ODZ-UJF-AV-CR/balon/SW/spi/README.md

PCRD detector scripts

Add following lines to /etc/modules in order to preload modules requiered for communication with the detector:

    spi-s3c64xx
    spidev
