ODZ-UJF-AV-CR/balon/doc/FIK_flights.odt

Flight | FIK-1 | FIK-2 | SP9UOB | FIK-3 | FIK-4 | FIK-5 | FIK-6 | FIK-7
Location | CZ (2015) | CZ (2017) | PL | CZ (2018) | SE (2019) | CZ (2019) | CZ (2020) | CZ (2021)
Payload | Candy detector Web camera | Candy detector, 360 deg camera | AIRDOS | AIRDOS | AIRDOS, SPACEDOS, GM, Socrat-R | AIRDOSC, SPACEDOS, GM, 360 deg camera | AIRDOSC, SPACEDOS, GM, Ionmeter, 360 deg camera | SPACEDOS, PiTED, 360 deg camera
Landing site | vineyard Austria | rapeseed field | | Poland | swamp | forest | railway corridor | Poland
Power source | Li-ion 18650 accu | Li-ion 18650 and li-pol accu | | Lithium primary cells and li-pol accu | Lithium primary cells | Lithium primary cells and LiIon Power Bank | Li-ion 18650 accu and LiIon Power Bank | Lithium primary cell and LiIon Power Bank
Telemetry system | GSM | GSM 868 MHz Proprietary Modem | Outsourced | SigFox (Poland) Proprietary Modem | Outsourced | 1x LoRa 1x SigFox 1x SiK 433 MHz | 2x LoRa 1x SiK 433 MHz | 1x LoRa
Rescue beacon | 433 MHz CW | 433 MHz CW | | 433 MHz CW | Outsourced | 433 MHz CW | 433 MHz CW | 433 MHz CW
Flight control computer | Odroid-U2 | Odroid-U2 | | Not used | Not used/outsourced | PX4, FMU v5 | PX4, FMU v5 | DATALOGGER01A
