ODZ-UJF-AV-CR/balon/data/151219_flight/3-spectrum/README.md

# Ballon data analyse

## Separation of noise

We can see a noise at low channels of the PCRD.

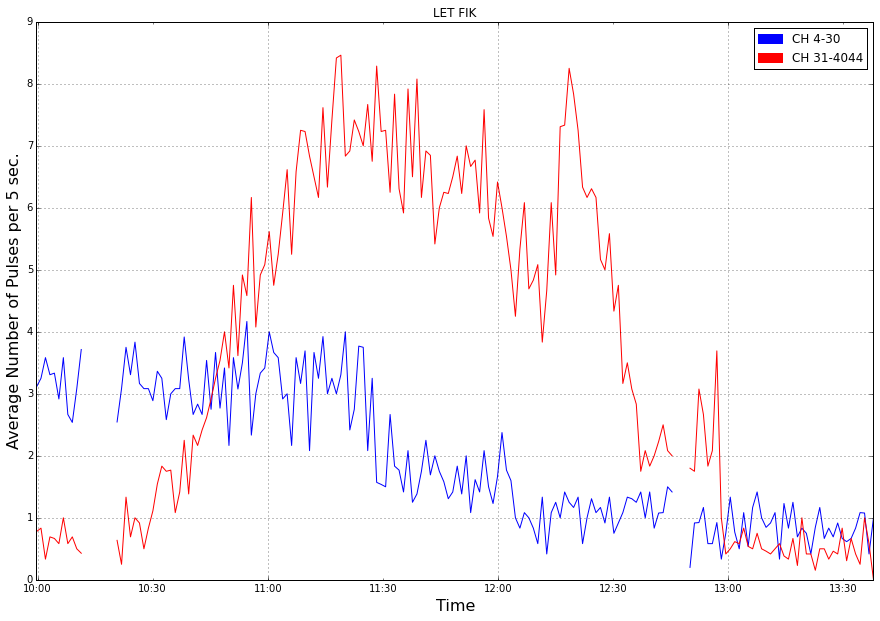
[picture p5: data/151219_flight/3-spectrum/noise.png]
Noise visualisation


## Energy spectrum

There is an energy spectrum aggregated from each 2 km altitude.

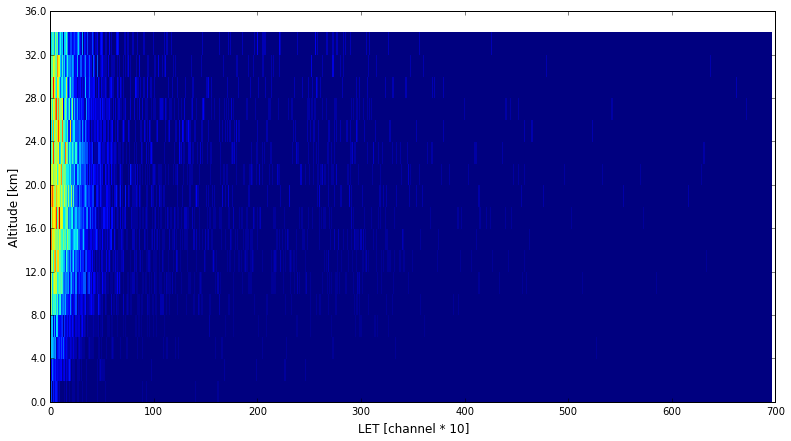
[picture p6: data/151219_flight/3-spectrum/spectrum.png]
Energy spectrum
