ODZ-UJF-AV-CR/balon/SW/Telemetry_receiver/sigfox/README.md

# CLI based Balloon telemetry decoder 

### Compilation

    gcc BalloonPos.cpp -o BalloonPos

### Usage 

    ./BalloonPos

Then enter the sigfox message. For example: 23a0fc0a3c1300f606c20993
You should get following as output: 

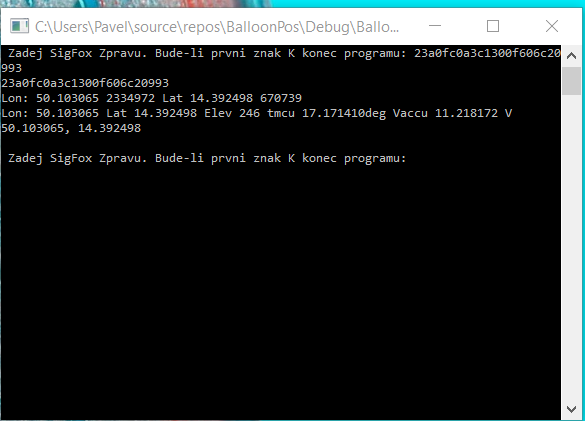
[picture p7: SW/Telemetry_receiver/sigfox/example_screenshot.png]
Decoded Balloon position from sigfox message Sigfox decoder output


# Web based Balloon telemetry decoder 

### Usage 

    python habitat_sigfox_uploader.py LetFik3

### Testing
 
    curl -G --data "data=23a0fc0a3c1300f606c20993" localhost:8080

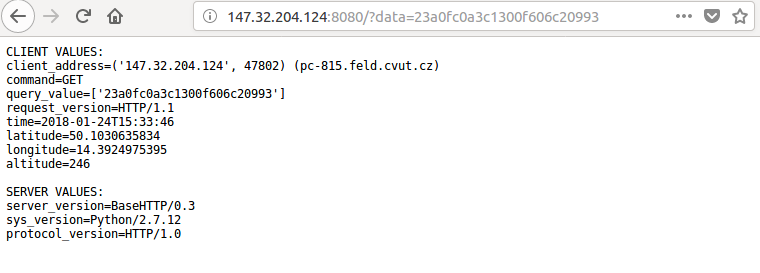
[picture p8: SW/Telemetry_receiver/sigfox/sigfox_web_interface.png]
Decoded Balloon position from sigfox API Sigfox Web interface decoder
