ODZ-UJF-AV-CR/balon/CAD/src/Receiver_box/Receiver_box_Small.png

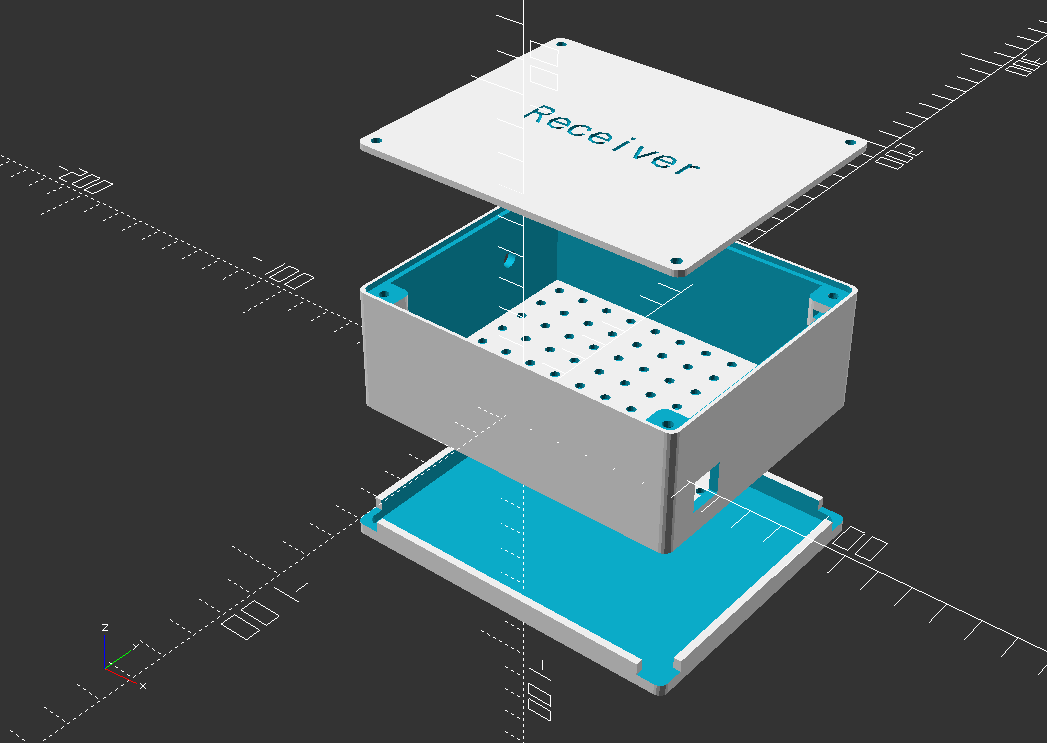
CAD/src/Receiver_box/Receiver_box_Small.png
