ODZ-UJF-AV-CR/balon/data/170318_flight/notes/altitude-and-position/fik2.png

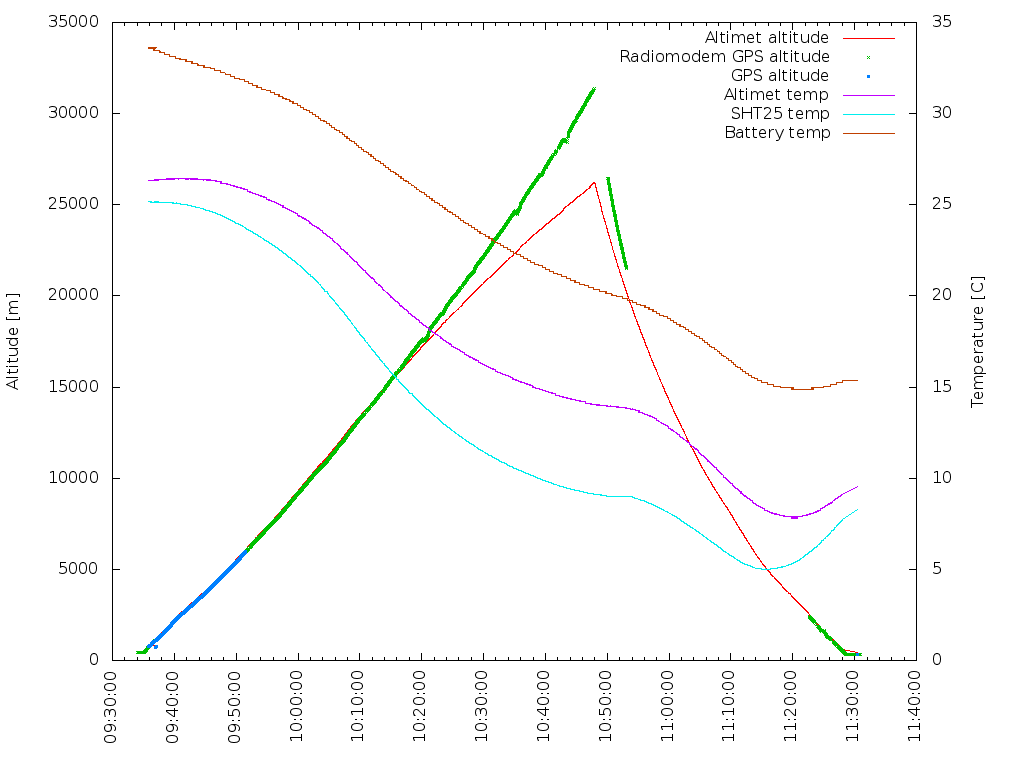
data/170318_flight/notes/altitude-and-position/fik2.png
