ODZ-UJF-AV-CR/balon/doc/433MHz_car_antenna/img/433MHz_antenna1.jpg

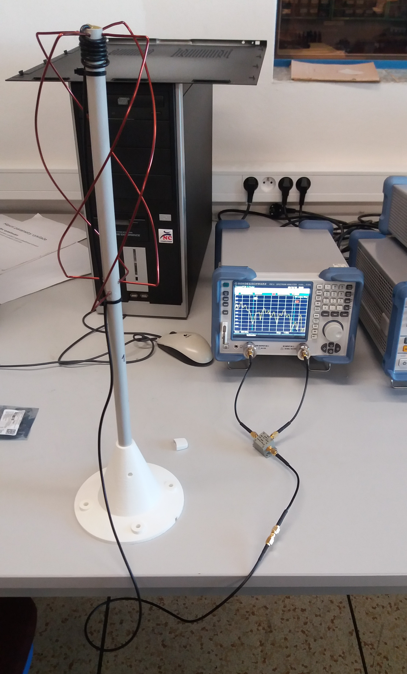
doc/433MHz_car_antenna/img/433MHz_antenna1.jpg
