ODZ-UJF-AV-CR/balon/doc/433MHz_car_antenna/img/433MHz_antenna1_S11.png

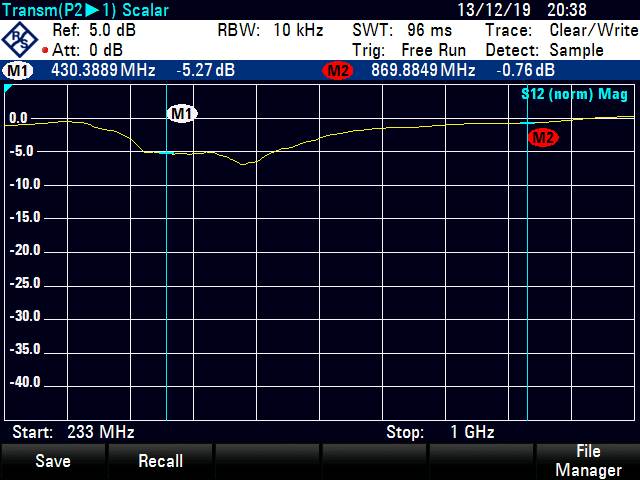
doc/433MHz_car_antenna/img/433MHz_antenna1_S11.png
