ODZ-UJF-AV-CR/balon/doc/433MHz_car_antenna/img/slicing.png

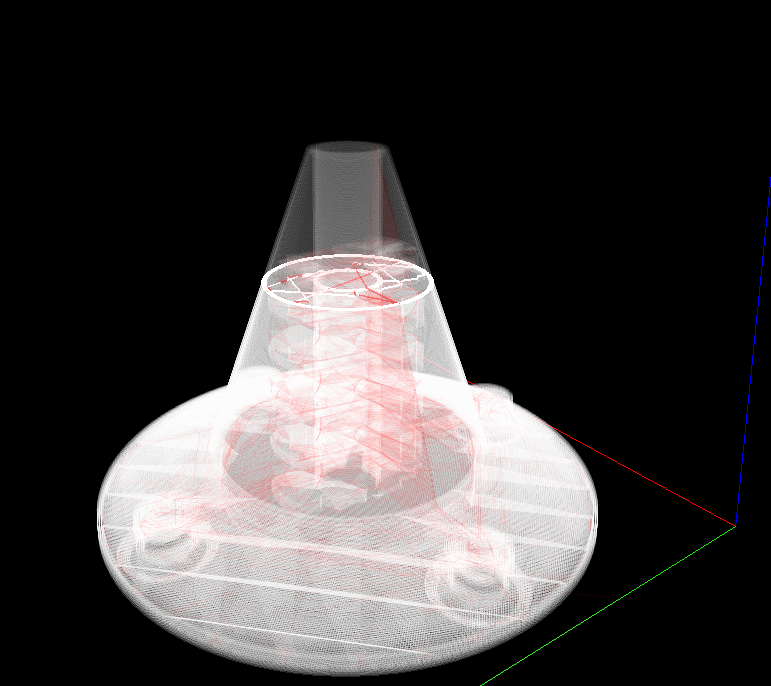
doc/433MHz_car_antenna/img/slicing.png
