ODZ-UJF-AV-CR/balon/doc/GPSdataloger/datalogger_blocks.png

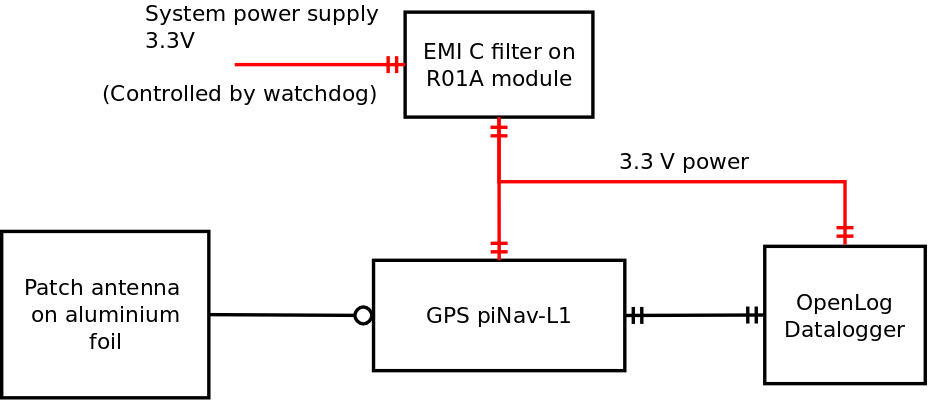
doc/GPSdataloger/datalogger_blocks.png
