ODZ-UJF-AV-CR/balon/doc/Transceiver/img/20170310_132159.jpg

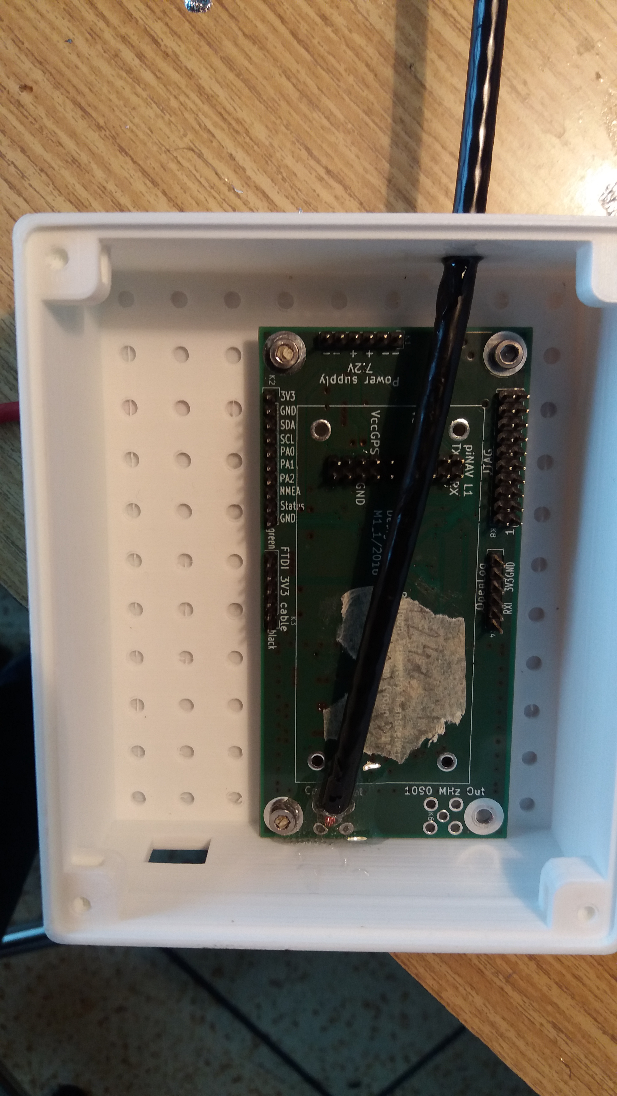
doc/Transceiver/img/20170310_132159.jpg
