ODZ-UJF-AV-CR/balon/doc/Transceiver/img/20170310_132207.jpg

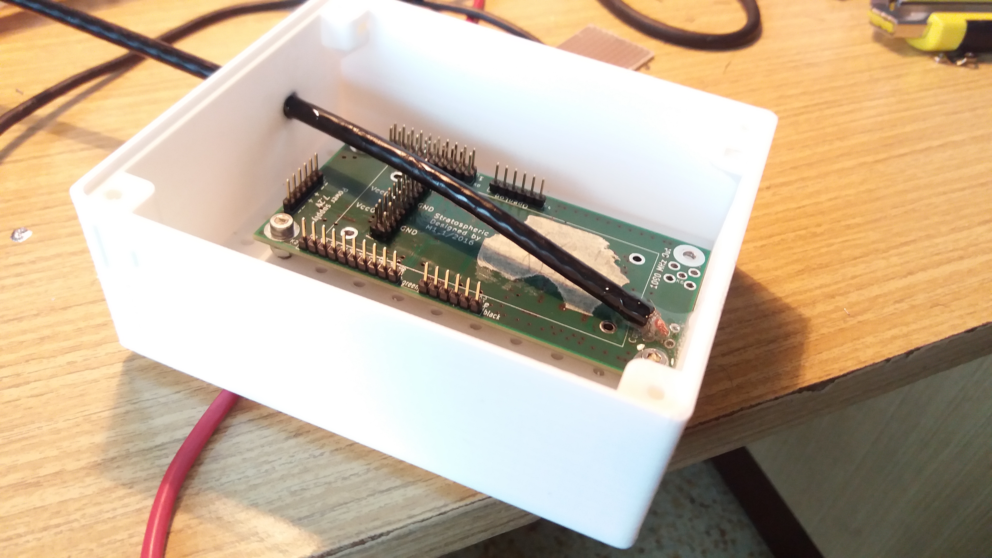
doc/Transceiver/img/20170310_132207.jpg
