ODZ-UJF-AV-CR/balon/fik5/telemetry/20190923_163317.jpg

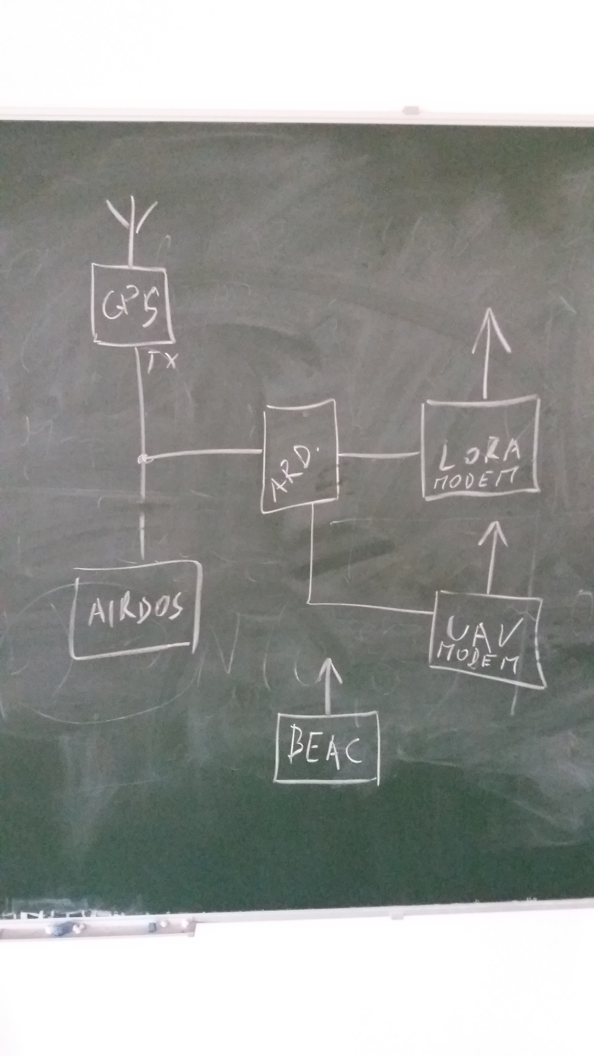
fik5/telemetry/20190923_163317.jpg
