ODZ-UJF-AV-CR/balon/HW/transceiver_M1_1_2016/modballoon.png

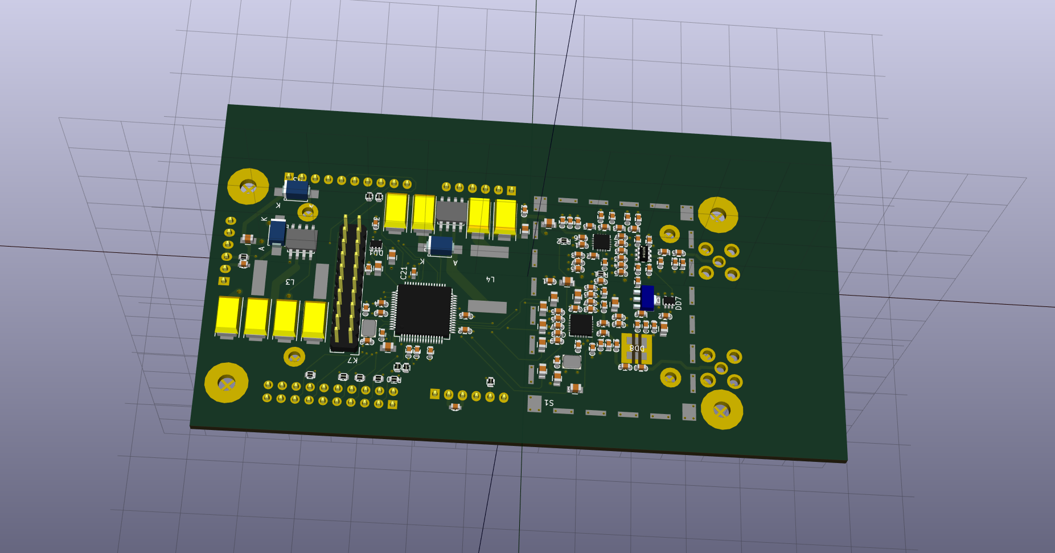
HW/transceiver_M1_1_2016/modballoon.png
