ODZ-UJF-AV-CR/balon/presentation/bloky/schema.png

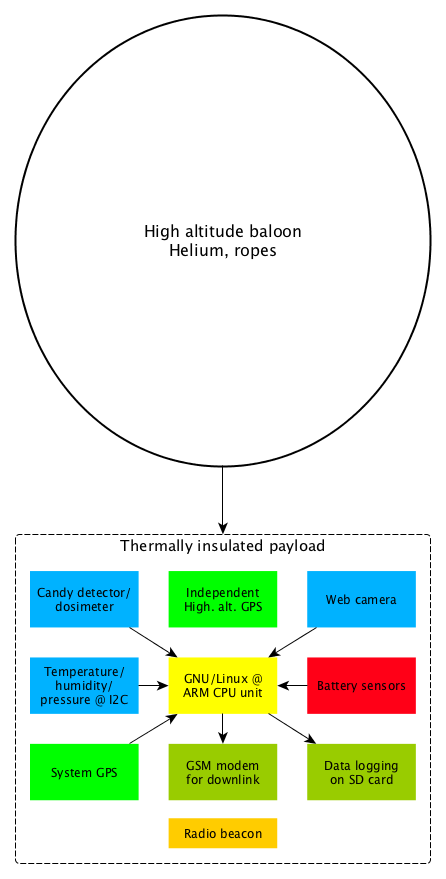
presentation/bloky/schema.png
