ODZ-UJF-AV-CR/balon/SW/beacon/DOC/beacon_schematics.png

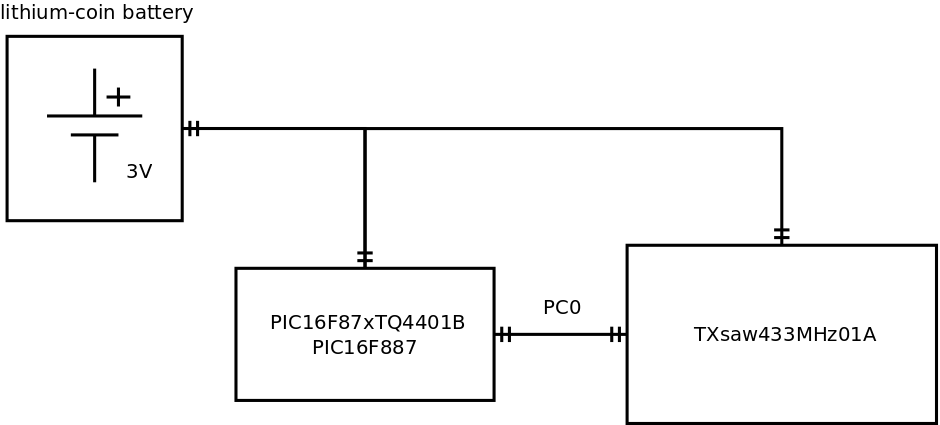
SW/beacon/DOC/beacon_schematics.png
