ODZ-UJF-AV-CR/balon/CAD/src/Receiver_box/AMF/assembly.stl

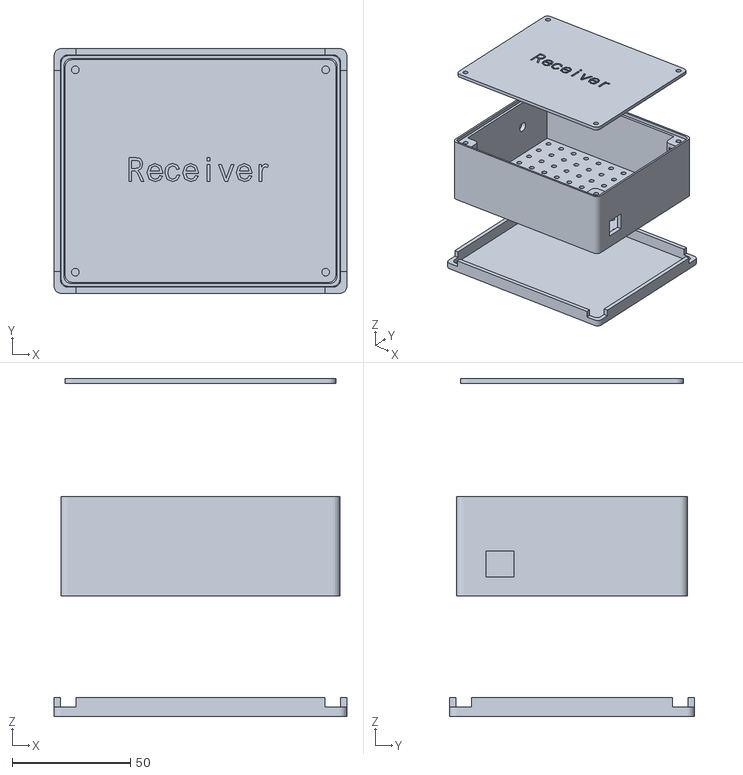
[picture p26: CAD file, 2017-03-09]
CAD/src/Receiver_box/AMF/assembly.stl
124.0 x 103.7 x 143.1
