ODZ-UJF-AV-CR/balon/CAD/src/Receiver_box/AMF/BASEBOX02A_kryt.stl

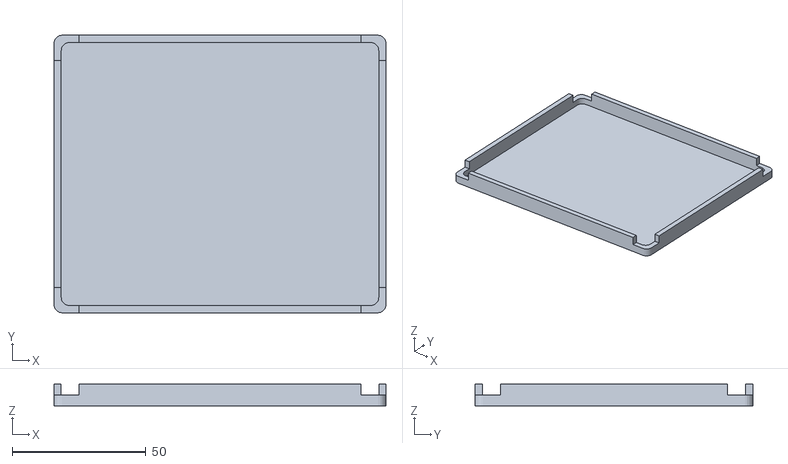
[picture p27: CAD file, 2017-03-15]
CAD/src/Receiver_box/AMF/BASEBOX02A_kryt.stl
124.0 x 103.7 x 8.10
