ODZ-UJF-AV-CR/balon/CAD/STL/camera_holder.stl

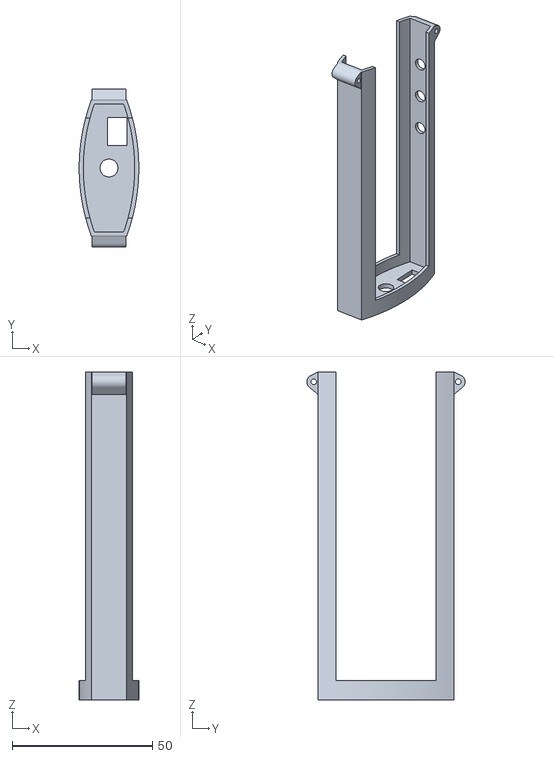
[picture p28: CAD file, 2019-11-26]
CAD/STL/camera_holder.stl
21.3 x 56.5 x 117.0
