ODZ-UJF-AV-CR/balon/CAD/src/Receiver_box/AMF/BASEBOX02A.stl

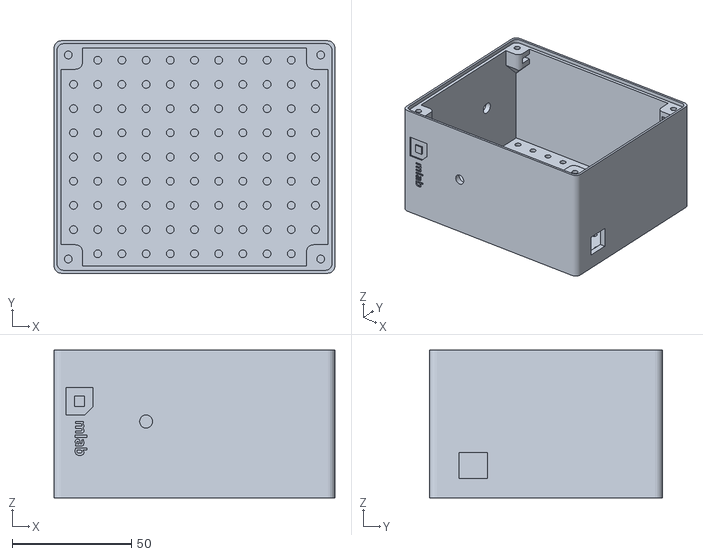
[picture p29: CAD file, 2017-03-13]
CAD/src/Receiver_box/AMF/BASEBOX02A.stl
118.0 x 97.7 x 62.1
