ODZ-UJF-AV-CR/balon/CAD/STL/antenna_holder.stl

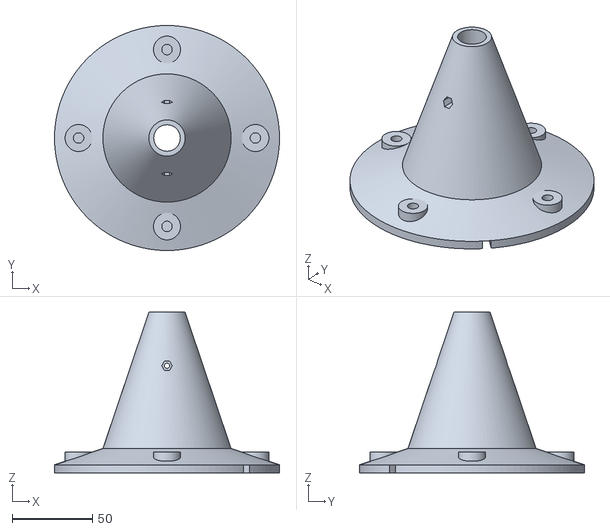
[picture p30: CAD file, 2019-11-21]
CAD/STL/antenna_holder.stl
140.0 x 140.0 x 100.0
