ODZ-UJF-AV-CR/balon/CAD/src/Receiver_box/AMF/BASEBOX02A_PLBASE_top.stl

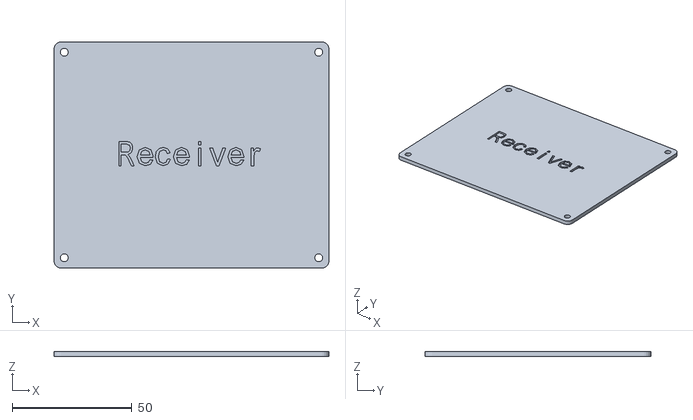
[picture p31: CAD file, 2017-03-09]
CAD/src/Receiver_box/AMF/BASEBOX02A_PLBASE_top.stl
114.6 x 94.3 x 2.10
