ODZ-UJF-AV-CR/balon/CAD/STL/VzorkovnikSloupkuNaSroubM3.stl

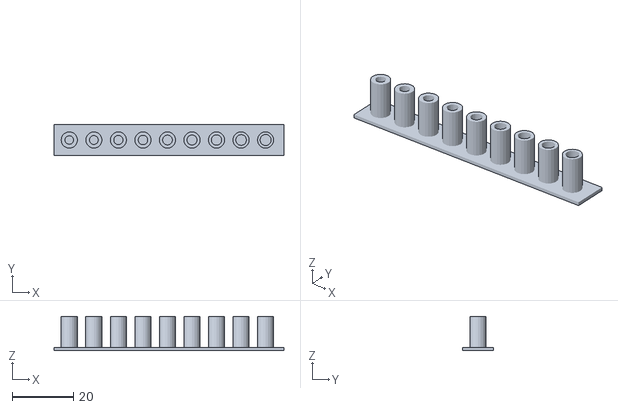
[picture p32: CAD file, 2018-01-23]
CAD/STL/VzorkovnikSloupkuNaSroubM3.stl
75.0 x 10.0 x 11.2
