ODZ-UJF-AV-CR/balon/CAD/STL/BoxBase-Fik3.stl

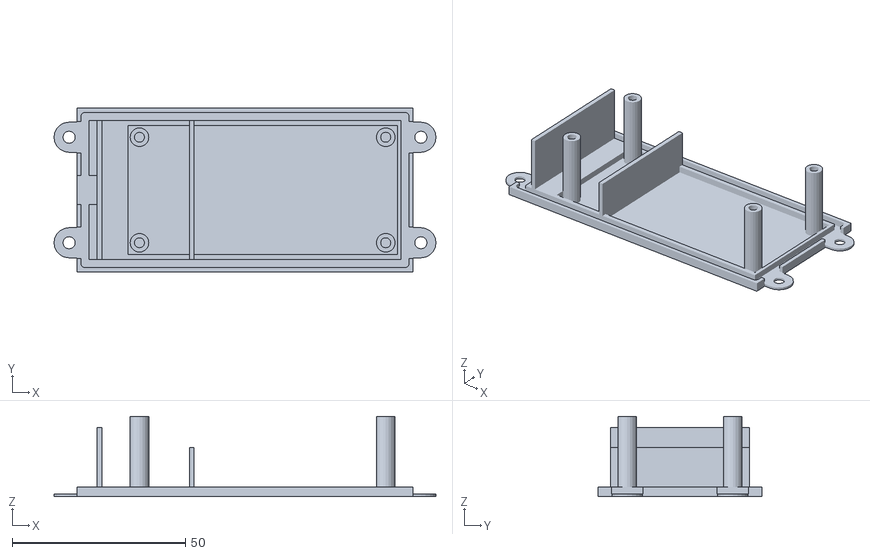
[picture p33: CAD file, 2018-01-22]
CAD/STL/BoxBase-Fik3.stl
110.3 x 47.2 x 23.2
