ODZ-UJF-AV-CR/balon/CAD/STL/Box-Fik3.stl

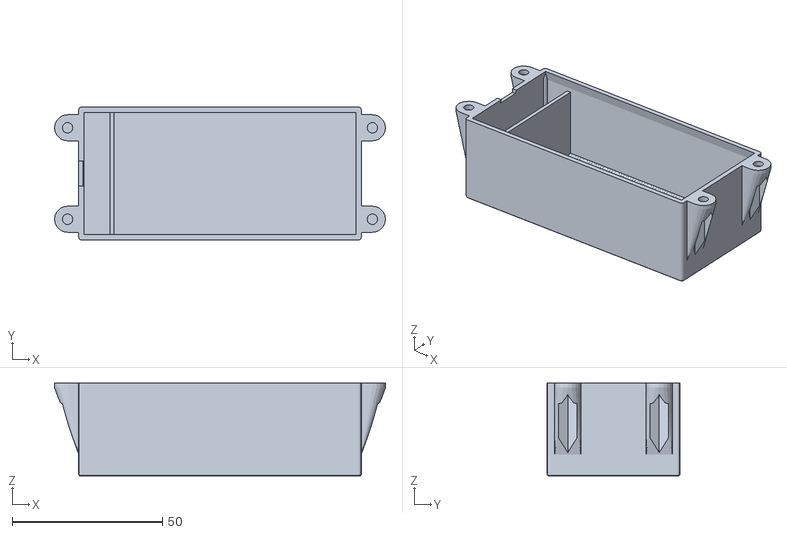
[picture p34: CAD file, 2018-01-21]
CAD/STL/Box-Fik3.stl
110.3 x 44.2 x 30.9
