ODZ-UJF-AV-CR/balon/CAD/STL/Base-Fik3.stl

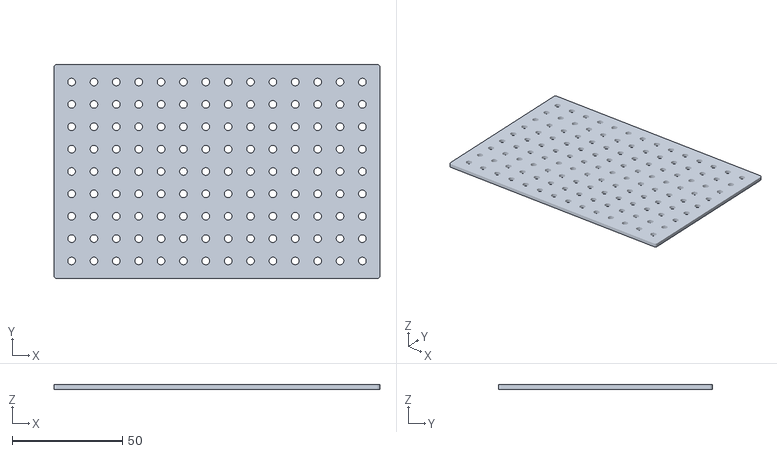
[picture p35: CAD file, 2018-01-19]
CAD/STL/Base-Fik3.stl
148.1 x 97.3 x 2.10
