ODZ-UJF-AV-CR/balon/CAD/STL/Grid_Holder_longer.stl

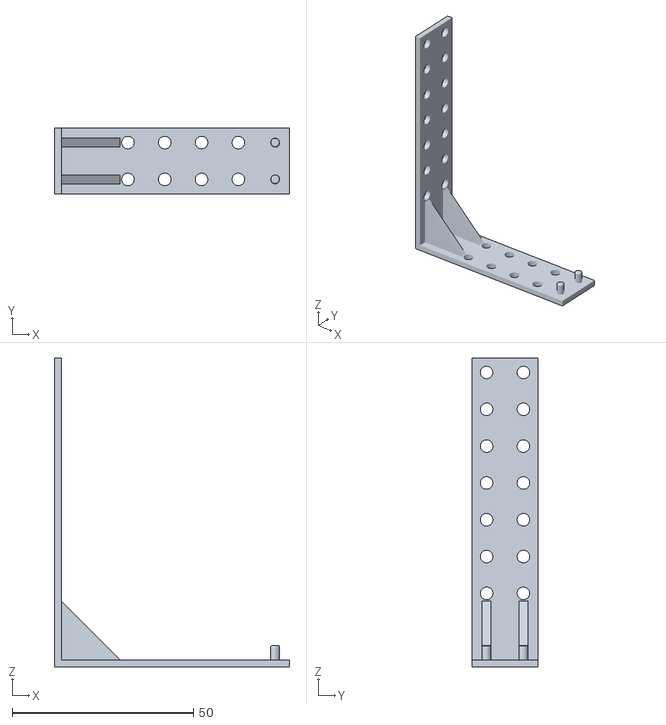
[picture p36: CAD file, 2017-03-16]
CAD/STL/Grid_Holder_longer.stl
65.0 x 18.2 x 85.3
