ODZ-UJF-AV-CR/balon/CAD/STL/Grid_holder.stl

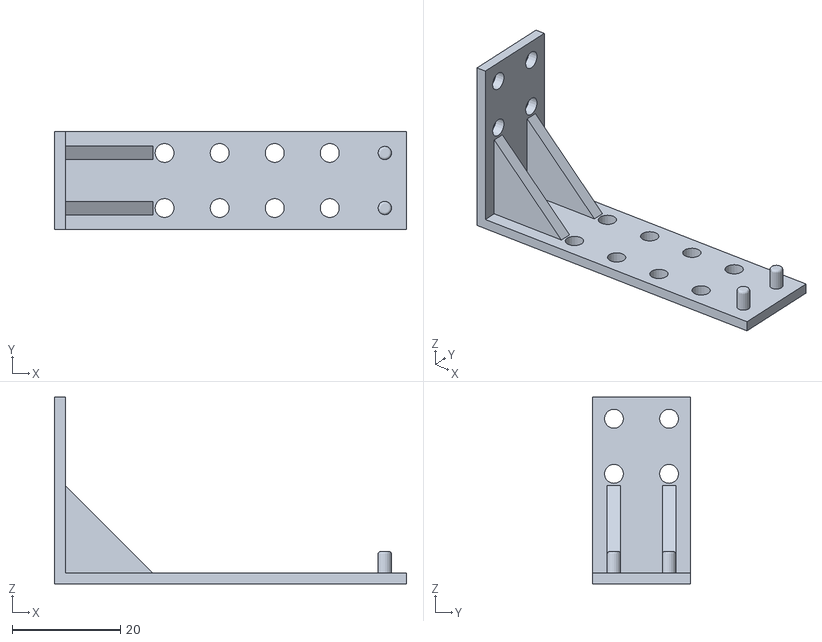
[picture p37: CAD file, 2017-03-15]
CAD/STL/Grid_holder.stl
65.0 x 18.2 x 34.5
