ODZ-UJF-AV-CR/balon/CAD/STL/Deska+C1_14.stl

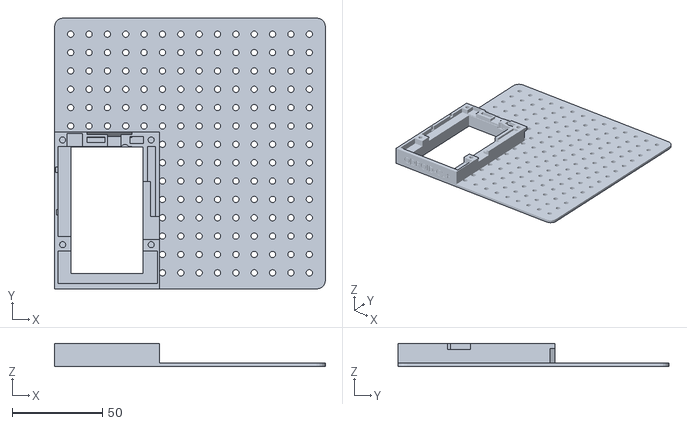
[picture p38: CAD file, 2017-03-09]
CAD/STL/Deska+C1_14.stl
150.0 x 150.0 x 13.0
