ODZ-UJF-AV-CR/balon/CAD/STL/PLBASE1515.stl

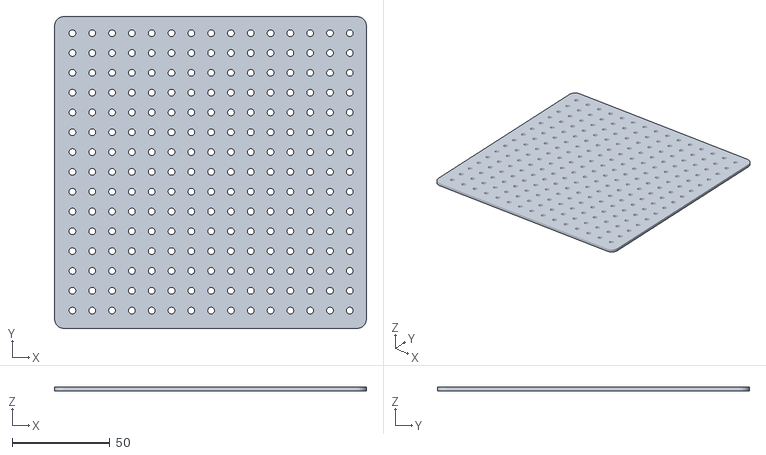
[picture p39: CAD file, 2015-12-07]
CAD/STL/PLBASE1515.stl
160.0 x 160.0 x 2.10
