ODZ-UJF-AV-CR/balon/(list of files, cad)

Other CAD files:
CAD/src/Receiver_box/src/text/Letters.dxf
CAD/src/PCRD_BOX/box_base.scad
CAD/src/PCRD_BOX/box_grid.scad
CAD/src/PCRD_BOX/box_top.scad
CAD/src/PCRD_BOX/Grid_Holder.scad
CAD/src/PCRD_BOX/Pokus6.scad
CAD/src/PCRD_BOX/Pokus7.scad
CAD/src/PLBASE1515.scad
CAD/src/Receiver_box/assembly.scad
CAD/src/Receiver_box/print_data/BASEBOX02A.scad
CAD/src/Receiver_box/print_data/BASEBOX02A_PLBASE_top.scad
CAD/src/Receiver_box/print_data/BASEBOX02A_kryt.scad
CAD/src/Receiver_box/src/MLAB_logo.scad
CAD/src/Receiver_box/src/manufactury_conf.scad
CAD/src/Receiver_box/src/otvory_conf.scad
CAD/src/Receiver_box/src/plbase.scad
CAD/src/Receiver_box/src/produkt_logo.scad
CAD/src/Receiver_box/src/sloupek.scad
CAD/src/Receiver_box/src/spodni_kryt.scad
CAD/src/Receiver_box/src/text/Write.scad
