ODZ-UJF-AV-CR/balon/(threads)

Thread 7 (2015-12-04):

Test hardware failure of sensor by sensor

vaclavstepan, 2015-12-04:

Closed 2019-09-16.

Thread 8 (2015-12-04):

Modem reset handling via i2c

vaclavstepan, 2015-12-04:

vaclavstepan, 2015-12-08:
On modem board there's reset and pwr_on pin. We might need to handle both?

vaclavstepan, 2015-12-16:
Vyžaduje druhý i2c hub, teď prostě nebude.

Closed 2015-12-16.

Thread 15 (2015-12-16):

Endless loop on fail in GSM mode

vaclavstepan, 2015-12-16:

vaclavstepan, 2015-12-16:
rxThread dies if the port is concurrently attached from other code.

vaclavstepan, 2015-12-17:
Seems to be solved, GSM thread closes and re-initializes modem connection on error.

Closed 2015-12-17.

Thread 20 (2015-12-16):

Implement average climb rate calculator.

vaclavstepan, 2015-12-16:
Given the GPS errors, this might be more precise, if just few messages are to be sent.

vaclavstepan, 2015-12-17:
Done, both for GPS and for the barometric pressure sensor.

Closed 2015-12-17.

Thread 21 (2015-12-16):

Modem power handling and SMS status dispatch in trigger conditions

vaclavstepan, 2015-12-16:
Where the trigger conditions are:
- Power on and GPS fix
- Climbing, 1500 m
- Climbing, 3000 m

Descending:
- below 7 km, good battery, one SMS
- below 5 km, every minute or 500 m, whatever is shorter
- below 2 km, every 30 sec or 200 m, whatever is shorter

Landed:
- Constant pressure: Send one SMS, then send a picture via PPP :-)

Climbing and descending should be based on GPS climb rate or delta alt (or fallback to pressure indicator). Triggers can be implemented in GSM thread.

vaclavstepan, 2015-12-17:
Requires average climb calculator to reliably say if we are ascending or descending.
In GPS this is returned as GPS_AvgClimb, a running average over last 10 GPS records with valid fix.

vaclavstepan, 2015-12-17:
AvgClimb now included in position SMS messages.

vaclavstepan, 2015-12-17:
Triggers are implemented as draft, see end of monitor.py.
This commit is offline testing setup.

Closed 2017-03-16.

Thread 22 (2015-12-16):

Dead thread monitors for GPS and GSM

vaclavstepan, 2015-12-16:
Implement monitoring and restart of GPS and GSM thread in case of failure.

Closed 2017-03-16.

Thread 23 (2015-12-17):

Altimet failure

vaclavstepan, 2015-12-17:
Občas z neznámých důvodů přestane fungovat vyčítání Altimetu. Přitom ostatní věci na i2c běží.

kakl, 2015-12-17:
Zkusime ho  vymenit.
Dne 17.12.2015 13:31 napsal uživatel "vaclavstepan" <
notifications@github.com>:

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

vaclavstepan, 2015-12-17:
Martin vyměnil, zatím to běží.

Closed 2015-12-17.

Thread 25 (2017-02-25):

Battery monitor

vaclavstepan, 2017-02-25:
Battery monitor reports nonsenses:

`BatTemp: -427.35 C RemCap: -1542 mAh FullCap: -1542 mAh U: -1542 mV I: -67078 mA Charge: -1542.00 %`

kaklik, 2017-02-25:
Za jakých podmínek se to stane?

vaclavstepan, 2017-02-25:
Kdykoliv. Pustim-li m_i2c.py i zkusím-li z pymlabu lion.py example (teda, verzi z minulyho roku).Vše včetně Temp se zdá konstantní a nesmyslné.Vasek                                                                                                                                                                                                                                                                                                                                        --Department of Radiation Dosimetry, Nuclear Physics Institute of the CAS, Prague, Czech Republic                                                                                                                                                                                                                From: Jakub KákonaSent: sobota, 25. února 2017 16:03To: ODZ-UJF-AV-CR/balonReply To: ODZ-UJF-AV-CR/balonCc: vaclavstepan; AuthorSubject: Re: [ODZ-UJF-AV-CR/balon] Battery monitor (#25)Za jakých podmínek se to stane?

—You are receiving this because you authored the thread.Reply to this email directly, view it on GitHub, or mute the thread.

{"api_version":"1.0","publisher":{"api_key":"05dde50f1d1a384dd78767c55493e4bb","name":"GitHub"},"entity":{"external_key":"github/ODZ-UJF-AV-CR/balon","title":"ODZ-UJF-AV-CR/balon","subtitle":"GitHub repository","main_image_url":"https://cloud.githubusercontent.com/assets/143418/17495839/a5054eac-5d88-11e6-95fc-7290892c7bb5.png","avatar_image_url":"https://cloud.githubusercontent.com/assets/143418/15842166/7c72db34-2c0b-11e6-9aed-b52498112777.png","action":{"name":"Open in GitHub","url":"https://github.com/ODZ-UJF-AV-CR/balon"}},"updates":{"snippets":[{"icon":"PERSON","message":"@kaklik in #25: Za jakých podmínek se to stane? "}],"action":{"name":"View Issue","url":"https://github.com/ODZ-UJF-AV-CR/balon/issues/25#issuecomment-282489481"}}}‎

vaclavstepan, 2017-02-25:
Martin Kákona vyřešil konektorem na I2C hubu, který zmenšuje možnost zapojit to blbě.

Closed 2017-02-25.

Thread 30 (2019-09-24):

Anténa pro LoRa

kaklik, 2019-09-24:
Již [navrženou QFH anténu](https://github.com/ODZ-UJF-AV-CR/balon/blob/master/CAD/STL/Telemetry_helix_868.stl) pro vysílač balonu je potřeba integrovat do konstrukce gondoly, nebo přídavné gondoly s telemetrickým vysílačem.

Předpokládám, že anténa bude připevněna na spodní stranu polystyrénové gondoly. Smyslem antény je vyzařovat do spodní hemisféry. Anténa má být právě v této charakteristice lepší, než obyčejná GP anténa, která vyzařuje do torusu, který ale ve výšce letu balonu nebude pokryt přijímacími stanicemi. Neboť nejbližší, přijímací stanice budou pod balonem.

cernohorsky, 2019-10-06:
Povedlo se mi postavit a změřit tuhle QFH anténu pro 868 MHz, ale první výsledky byli neuspokojivé. Ukázalo se, že samotný model přidává anténě parazitní kapacitu a výrazně ji rozladí. Pomocí kalkulátoru (http://jcoppens.com/ant/qfh/calc.en.php) jsem ji přepočítal na vyšší frekvenci a upravil 3D model. Po několika iteracích jsem se dostal na požadovanou frekvenci.

https://github.com/cernohorsky/QFH-Antenna-868MHz

Zbýva dořešit 2 věci:
1. Myslím, že by bylo potřebné změnit "Width/height ratio" aby jsme dosáhli větší směrovosti. http://jcoppens.com/ant/qfh/sim.en.php
2. Vyřešit symetrizaci antény. Teď je anténa přizpůsobená na 50 ohmů (VSWR 1.32), ale přívodní koax může ovlivňovat vyzařovací charakteristiku. Myslím, že by chtělo přidat na feed point balun, nebo aspoň ferrit.

kaklik, 2019-10-06:
Nejsem si jistý, jestli větší směrovost je zrovna to, co je potřeba. Neboť když balon bude už nízko, tak je stále potřeba, aby byl přijímatelný stanicemi. Takže bych navrhoval směrovost antény naopak snížit,

Symetrizace antény - zde očekávám, že by měl stačit ferit a ověřit směrovou charakteristiku třeba nějakou mustikoptérou.  Kdybys chtěl používat balun, tak jaký typ bys navrhoval zvolit?

cernohorsky, 2019-10-07:
S tou smerovosti uprimne nevim, rikal jsem si, ze primat telemetrii na 30 km vzdalenost chce co nejvetsi zisk. Ale je pravda ze pri nizkych vyskach se situace obraci. Predpokladam ze dohledavani te sondy je priorita.
Jinak mne osobne se libi tenhle balun:
https://www.mouser.de/ProductDetail/TDK/HHM1776B2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
Ale skutecne je potreba tu antenu nejdriv zkusit, pokud bude fungovat uz bych do ni nerejpal...

kaklik, 2019-10-07:
Ano konečné dohledání je priorita. Ze zkušeností z předchozích letů vyplývá, že zisk přenosu v maximální výšce není třeba řešit, neboť v případě sigfoxu balon viděly stovky stanic po celé Evropě (byla použita 1/2 GP anténa ). To že balon vidělo tolik stanic byl problém, neboť síť ta takovou situaci není stavěná a o některé zprávy se díky tomu přišlo, navíc zpracování zpráv trvalo hodiny.  Proto je výhodné směrovou charakteristiku omezit na vyzařování dolu, ale ne moc, aby ve svazku vždy nějaká gateway byla.

Ten balun je zajímavý ale má Insertion Loss: 1.2 dB. Předpokládám, že je to tím že je velmi malý. Neexistuje nějaká jeho varianta, která by byla větší a tím pádem měla i menší ztráty?
Použití takového balonu bych asi viděl jako optimální, pokud by LoRa modem byl přímo součástí antény. Což by bylo dobré v případě, že by od antény mohly vést přímo SPI vodiče do autopilota viz issue #26

cernohorsky, 2019-10-07:
Bohuzel zadny lepsi jsem nenasel. Jinak optimalni by podle mne bylo kdyby ten balun byl primo ve feed point. Nejlepsi by byla mala DPS kde by se knemu pripojili jednotlive segmenty anteny. Ale jelikoz je ten Insertion Loss tak velky uvazoval bych o tom jen kdyz to bude potreba.
A nemyslim si ze je dobre integrovat LoRa modem s antenou. RFM95 dokaze pracovat max. do -20 °C.

kaklik, 2019-10-09:
To je docela škoda, ten modem neintegrovat s anténou, protože by to vyřešilo napájení antény a stejně pro LoRa modem bude zřejmě potřeba udělat PCB.
Modem by ale mohl být připojený k anténě dvojlinkou (podobně jako navrhuji v issue #33 ), což by umožnilo ho dát do gondoly, kde nezmrzne.

Ten PCB pro nějaký LoRa modul ale bude potřeba tak jako tak, neboť LoRa modem je potřeba připojit na [SPI port](https://pixhawk.org/pixhawk-connector-standard/) autopilota, který má [JST-GH konektory](http://www.jst-mfg.com/product/detail_e.php?series=105) předpokládám že autopilot se pak s modemem propojí 7pinovým kablíkem 1:1 s těmito konektory.

cernohorsky, 2019-10-09:
Puvodne jsem myslel ze pouzijeme tohle:
https://github.com/hallard/Mini-LoRa
Je totiz pripravena na SMA (nebo UFL) konektor. Mam osazene 2 DPS a dalsich 8 neosazenych. Btw. tato DPS musi byt napajena z 3,3V a doufam ze i ten autopilot komunikuje na 3,3V...
Ale muzeme pouzit i moji DPS:
https://github.com/cernohorsky/LoRa-Node
ISP konektor je vlastne SPI rozhrani. Antenu bych odrezal a dobastlil tam nejak SMA konektor. Bude to sice trochu bastl, ale slo by to pouzit hned a tahle varianta by byla urcite ta nejmensi a nejlehci.

kaklik, 2019-10-09:
Ano, podle odkazu, který jsem poslal autopilot komunikuje na 3V3 a poskytuje 5V napájení.

Když se dívám do schéma těch desek, tak ani jedna není uzpůsobena na 5V napájení od autopilota navíc ten CPU je tam zřejmě nadbytečný.  Viděl bych to tak spíš na nakreslení nové desky, speciálně pro připojení k autopilotovi.  Nezdá se mi moc nápad tam SMA konektor "nějak dobastlit", když na tom závisí, jestli ten balon najdeme.
Úprava firmware ale na těchto deskách zřejmě otestovat jde.

cernohorsky, 2019-10-09:
Klidne tu DPS navrhnu. Ale ten mikrokontroler tam je dulezity. RFM95 je "hloupy" modul a knihovna LMIC musi udalat cely "LoRa stack". Tohle je dan za tu nizkou cenu...

kaklik, 2019-10-09:
Mě to právě přijde bezpečnější mít v tom driveru v autopilotovi, než tam mít další Arduino.  Co si o tom myslíš @povik ?

kaklik, 2019-10-09:
Ještě je pak možnost použít [modul od microchipu](https://www.microchip.com/wwwproducts/en/RN2483), ale tam je ten procesor akorát schovaný uvnitř toho modulu. Což sice chápu, že pravděpodobně zjednodušuje vývoj software, ale zároveň je to další vrstva, kterou se vzdalujeme od kontroly nad tím hardware. Takže můžou vznikat různé potíže při inicializaci a nebo při resetu.

kaklik, 2019-10-09:
@povik Možná ti ušetřím trochu času informací že [RFM95](https://cdn.sparkfun.com/assets/learn_tutorials/8/0/4/RFM95_96_97_98W.pdf) a třeba [tenhle modul](http://www.dorji.com/docs/data/DRF1276G.pdf) ve skutečnosti používají ten [stejný čip SX1276](https://www.semtech.com/products/wireless-rf/lora-transceivers/sx1276#download-resources)
A liší se především tím, že já mám DRF1276G se stíněnou krabičkou a @cernohorsky  má RFM95 na svém modulu. Možná by bylo nejlepší se na tyhle mezimoduly vykašlat a prostě použít přímo třeba čip [SX1262](https://www.semtech.com/products/wireless-rf/lora-transceivers/sx1262) a postavit na něm plnohodnotný MLAB modul. Výhodou takového řešení by byly známé a pravděpodobně lepší parametry použitých komponent a použití novějšího transceiveru s větším výstupním výkonem (+22 dBm)

cernohorsky, 2019-10-10:
Ten SX1262 vypada moc pekne a rad takovy modul udelam, ale SW je uz nad me sily. Tuhle knihovnu ted pouzivam: https://github.com/matthijskooijman/arduino-lmic
Myslite ze by sla ohnout na ten SX1262?

kaklik, 2019-10-10:
@cernohorsky  Netuším, jak ta knihovna funguje, takže nevím. Přijde mi podivný, že potřebuje to připojení na IO piny, každopádně jestli to jde, tak si myslim, že to pro Arduino dřív nebo pozdějc někdo udělá.

Teď ale momentálně řešíme, jak to nejlépe připojit do [PX4](https://github.com/PX4/Firmware/tree/master/src/drivers/telemetry).

cernohorsky, 2019-10-10:
Tohle jsem nasel v dokumentaci LMIC (README.md na github strance):
"The LMIC library was intended to connect the DIO pins to interrupt lines and run code inside the interrupt handler. However, doing this opens up an entire can of worms with regard to doing SPI transfers inside interrupt routines (some of which is solved by the Arduino beginTransaction() API, but possibly not everything). One simpler alternative could be to use an interrupt handler to just store a timestamp, and then do the actual handling in the main loop (this requires modifications of the library to pass a timestamp to the LMIC radio_irq_handler() function)."

Celkove je cela ta sekce "Timing" hodne zajimava...

kaklik, 2019-10-11:
Dobře, v tom případě jsem přímo pro použití SX1262 kvůli většímu výkonu. Dále to navrhuji řešit v tomto issue: https://github.com/ODZ-UJF-AV-CR/balon/issues/26
A tohle nechat pro záležitosti související s anténou.

@ChroustJan zřejmě je tak jasná konstrukce modulu.  Potíž s připojením na SPI budeme řešit na straně autopilota, nikoliv na straně modemu.

cernohorsky, 2019-10-11:
Ty knihovny resi skutecne LoRa-WAN komunikaci? SX1276 totiz umi i point to point LoRa a obycejnou FSK komunikaci a ty se nam vubec nehodi...

povik, 2019-10-11:
@cernohorsky Je to tak, řeší i LoRaWAN. Třeba tady jsem našel implementaci uvolněnou Semtechem.

https://github.com/Lora-net/LoRaMac-node

cernohorsky, 2019-10-14:
OK potom je vse v poradku. Klidne tu DPS pro SX1262 navrhnu, ale rikam si jestli to stoji za namahu. Chvili potrva nez to udelam a pak se bude dlouho cekat na tistaky. A beztak budu muset jen zkopirovat referencni design. Nebylo by lepsi koupit evaluation module primo od semtechu?
https://www.mouser.de/ProductDetail/Semtech/SX1262MB2CAS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
Takhle bude mozne postavit funkcni protoyp do par dni...

kaklik, 2019-10-14:
Dohodl jsem se s @povik  že zatím sestavím testovací desku s RFM95. Neboť pokud bude aplikovatelná knihovna od Semtechu, tak by pro software neměl být rozdíl čipů překážkou.
Ty tak máš více času na návrh té správné DPS s SX1262 můžete na tom klidně pracovat i nějak společně s @ChroustJan

ChroustJan, 2019-10-14:
Ahoj, modul mám rozpracovaný. Určitě půjde spolupracovat.

Dne po 14. 10. 2019 11:05 uživatel Jakub Kákona <notifications@github.com>
napsal:

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

kaklik, 2019-11-20:
U antény je potřeba ještě doplnit mřížku na uchycení ze spodu gondoly. V [mém kódu](https://github.com/kaklik/QFH-Antenna-433MHz/blob/master/QFH-Antenna-433MHz.scad#L76) jsem mřížku poupravil pro lepší tiskutelnost.

Také by asi nebylo špatné do modelu antény implementovat stejné odlehčení stěn.

kaklik, 2019-11-28:
Model od @cernohorsky  Jsem postupně upravil tak že jsem L/D ratio změnil až na 0.85 a přidal odlehčení a spodní mřížku sloužící k uchycení.

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

Výsledkem je anténa s ostrým minimem na rezonanční frekvenci.

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

Closed 2019-11-28.

Thread 33 (2019-10-05):

Anténa pro MAVlink telemetrii

kaklik, 2019-10-05:
Podobně jako v issue #30  telemetrický vysílač taktéž potřebuje anténu, avšak na jiné pásmo [433-434 MHz](https://www.ctu.cz/vyuzivani-vymezenych-radiovych-kmitoctu).

Anténa by taktéž měla být typu QFH a je potřebné, aby byla jak ve variantě pro balon tak i ve varinantě pro pozemní stanice (automobily s přijímací stanicí).

cernohorsky, 2019-10-07:
Pomalu se chystam na navrh tehle anteny, ale tuhle variantu bych docala rad udelal z koaxialniho kabelu a ne z postribrneho dratu. Koax by mnel vetsi prumer coz by mnelo zlepsit parametry anteny a muzu realizovat i "nekonecny balun", na druhou stranu antena bude tezsi. Ted ma verze pro 868 MHz 21.5g. Verze pro 433 MHz bude mit urcite vic jak 50 g, Jak moc jsme limitovani vahou celeho reseni?

cernohorsky, 2019-10-08:
Ta antena pro 433 Mhz je obrovska (v pozadi verze pro 868 Mhz):
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

A navyse porad neni spravne naladena, musim ji jeste vic zvetsit a uz tenhle model se mi sotva vesel do tiskarny:
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

kaklik, 2019-10-08:
Domnívám se, že průměr vodiče antény by na parametry antény, kromě šířky pásma mít vliv neměl, pokud bude zachována vodivost vodiče při různých průměrech.

Postříbřeným drátem tak lze realizovat i tenké vodiče a anténa tak bude mít malou šířku pásma, což pokládám za výhodu.

Nejde ten tištěný model nějak odlehčit?  Na celou gondolu máme předpokládám něco jako 1-2kg.

cernohorsky, 2019-10-08:
Taky se mi ta "koaxova varianta" moc nelibi. Nedokazu sni ani dodrzet spravne rozmery. O tom odlehceni jsem taky premyslel, ale rikam si jestli by nebylo nejlepsi,  obejit se uplne bez toho modelu. Kdyz jsem totiz delal variantu 868 MHz, tak jsem zkusil ten model pouzit jen jako kopyto a vysledek byl moc pekny:
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

Antena pak bude super lehka. Stacilo by pak zmerit jen vliv radomu.
Ma to jen dve uskali :
1.	Pro ground station toto reseni bude bezproblemove, ale jinak ta antena mechanicky nic nevydrzi. Staci jen lehky naraz a je po ni. Jeste by mozna stalo za to skusit ji udelat z klasickeho medeneho dratu. S prumerem 2mm by se mohlo porad dobre pracovat a antenna bude mnohem robustnejsi a presto porad lehka.
2.	Ten model bude vetsi nez 230mm a moje tiskarna uz tak velky model nevytiskne. Kopyto vytisknu z dvou kusu, ale radom by chtelo tisknout v celku a to uz nedam. Tiskne v Praze jeste nejaka RED-ka? 😉

kaklik, 2019-10-08:
Ta anténa by myslím mela vydržet pád gondoly na ní (anténa bude vespod) a je myslím hloupý po dopadu přijít o vysílání telemetrie.  Ten tištěný model by právě měl zajistit že se po dopadu anténa nezdeformuje.

Myslím že je snažší to nakrájet na menší díly, než se snažit to tisknout vcelku. Radom může být klidně slepený a anténa taky.

kaklik, 2019-10-09:
Ještě mě k té hmotnosti napadlo, zda nejde hmotnost ušetřit na přívodním koaxu k té anténě.
Ona totiž v podstatě stejně vyžaduje symetrický přívod, což koaxiální vedení nesplňuje. Také vidím potenciální problém s použitím SMA konektoru, protože je to typ konektoru který se povoluje a není to na něm poznat, máme s ním v tomhle smyslu špatné zkušenosti s použitím u GPS antén.

Navrhoval bych vyzkoušet napájení antény [kroucenou dvoulinkou](https://www.rf-microwave.com/en/nbp/nmp/pvc-insulated-twisted-pair-silver-plated/frb-01/), jejíž připojení k asymetrickému výstupu měřáku lze realizovat tím [transformátorem ETC1-1-13](https://cz.mouser.com/datasheet/2/249/ETC1-1-13-335562.pdf) o kterém jsem už psal.

Samotné připojení antén v balonu by bylo fajn, kdyby se obešlo bez RF konektoru. Ovšem všechny SiK modemy, které máme končí SMA, případně R-SMA konektorem.

cernohorsky, 2019-10-09:
Zmeril jsem hmotnost RG174 a 30 cm tohoto kabelu vazi jen 4,7 g. A pokud by tahle hmotnost presto vadila sel by pouzit pigtail. Ale ta kroucena dvoulinka neni uplne spatny napad, chtelo by to kouknout jak by to fungovalo. Co se tyce konektoru, tak nejjednoduchsi by bylo ty kabely natvrdo napajet na DPS, ale neni to moc prakticke reseni. Co takhle zkusit ten konektor pred letem zakapnout lakem na srouby?
https://eshop.wuerth-industrie.com/Kategorie-produktu/Lak-na-pojisteni-sroubu/15433005030601.cyid/1543.cgid/cs/CZ/EUR/

kaklik, 2019-10-09:
Jo, podobné lepidlo používáme pro GPS antény.  Nějak to funguje, jen se to musí udělat dobře, aby konektor zůstal vodivý.
Ale fajn, v tom případě kabel z hlediska hmotnosti zřejmě není potřeba řešit.

kaklik, 2019-11-12:
Anténa vyrobená o víkendu, podle těchto parametrů:

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

V takovémto provedení

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

Je naladěná takto:

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

kaklik, 2019-11-28:
Model antény jsem iteračně upravil na správnou rezonanční frekvenci.

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

Celá anténa včetně přívodu pak váží ~38g

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

Closed 2019-11-28.

Thread 37 (2019-11-20):

Držák antény na desku na autě

kaklik, 2019-11-20:
Do[ aktuálně navrženého držáku antény](https://github.com/ODZ-UJF-AV-CR/balon/blob/master/CAD/STL/antenna_holder.stl) je potřeba doplnit drážku pro vyvedení koaxu  o průměru 5mm bokem z trubky.

kaklik, 2019-11-28:
Anténa byla na střechu auta namontována s použitím 3D tištěného držáku.

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

Closed 2019-11-28.

Thread 40 (2019-11-30):

Zlepšit způsob připojení antén k balonu

kaklik, 2019-11-30:
Aktuální konstrukce antén pod gondolou funguje dobře, jako absorber nárazu při dopadu.
Antény je však potřeba po nárazu do země vyměnit za nové, neboť typicky dojde k prasknutí plastových dílů.
Překážkou k této operaci je nutnost odletování a zpětného zaletování smyček antény na přívodní koax, což je časově náročná operace, která trvá přes hodinu.
Podstatně by to však mohly změnit dvě konstrukční úpravy.

- [x] Antény přichytit na suchý zip zespodu gondoly
- [x] Vyřešit [potíž s připojením koaxiálního kabelu](https://github.com/cernohorsky/QFH-Antenna-868MHz/issues/1).

kaklik, 2020-10-19:
Výrazně by tomuto mohla pomoci úprav abalunu od @cernohorsky
Viz: https://github.com/cernohorsky/AntennaBalun/issues/1

kaklik, 2020-10-27:
### Připojení antény ke koaxiálnímu kabelu

@cernohorsky  Navrhl úpravu svého balunu k dipolové anténě, která řeší problém s připojením kabelu k anténě.
Je zde: https://github.com/ODZ-UJF-AV-CR/QFHBAL01

@ChroustJan Ten plošný spoj jde rozměrově trochu upravit. Myslíš že pak bude možné jej přidat k nějaké aktuální výrobě PCB?

### Uchycení antény na gondolu

Anténa momentálně má na spodní straně vytištěnou mřížku, která sloužila k připevnení ke gondole lepící páskou. Tento způsob připojení se celkem osvědčil, ale není moc flexibilní.

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

Navrhoval bych mřížku upravit tak, aby v rozích byly plné čtverečky na které se přilepí [samolepící suchý zip](https://www.azktrade.cz/3m-sj3550-dual-lock-samolepici-suchy-zip-cerny-4/).  Stejný suchý zip by pak byl nalepen ze spodní strany na gondole.
Anténu by mohl upravit někdo, kdo dovede pracovat s OpenSCADem. Třeba @Alsa-Tucnak  ?

Alsa-Tucnak, 2020-11-03:
Anténu upravit můžu. Jen je potřeba zajistit opravdu dobře její uchycení. U té mřížky mi přijde, že je dost velká p-st, že se od spirály odlomí. 4 suché zipy v rozích by mohly držet dobře snad. Zkusím tedy sehnat suchý zip a upravit anténu.

kaklik, 2020-11-03:
> Anténu upravit můžu. Jen je potřeba zajistit opravdu dobře její uchycení. U té mřížky mi přijde, že je dost velká p-st, že se od spirály odlomí. 4 suché zipy v rozích by mohly držet dobře snad. Zkusím tedy sehnat suchý zip a upravit anténu.

Super! :)  Nevím jak to myslíš s tím odlomením mřížky od spirály.  Přijde mi, že by došlo k úplně destrukci antény, kdyby se tohle mělo ulomit.

Jinak do toho komentáře výše jsem dal odkaz na konkrétní typ suchého zipu (dual-lock), který by se tam myslím měl použít.

kaklik, 2020-11-06:
Jinak prostřední část té 3D mřížky ve spodní části antény bude potřeba upravit tak, aby na ní bylo možné připevnit [tento plošný spoj](https://github.com/ODZ-UJF-AV-CR/QFHBAL01).

Dovedu si představit, že by to bylo realizované tak, že na mřížce budou vytištěny 3 trny, které zapadnou do třech montážních děr tohoto plošného spoje.  Tím by byla i definována jeho orientace, neboť tam musí být upevněn ve správné rotaci.

Potom ty tři vytištěné trny půjdou rozmáčknout něčím horkým, aby z nich plošný spoj nespadl.

Anténa by se tak sundavala jako celek, kdy se připojí kabel do konektoru plošného spoje a celá anténa se přilepí na suché zipy.

kaklik, 2020-11-22:
Zde jsem [exportoval rozměrový výkres QFHBAL01](https://github.com/ODZ-UJF-AV-CR/QFHBAL01#mechanical-drawing)

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

kaklik, 2020-11-24:
Nový kód jsem sloučil s původnim kódem, aby nevznikalo  příliš mnoho variant (původní anténa už nemá žádné využití).

Řešení kdy plošný spoj bude nasazen na kuželové trny, je docela revoluční, ale asi dobré. Neboť takhle není nutné řešit přesné tolerance otvorů :)

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

Průměr otvoru v PCB je 3.2mm. To jsem na obrázku výše zapomněl. Pro aktuální trn to znamená, že zřejmě plošný spoj bude někde lehce pod polovinou výšky trnu. Což je zřejmě správně. :)

Potíž nastává s umístěním trnů a s otvorem pro koaxiální konektor, který musí být vyveden zřejmě ze spodní strany.

Plošný spoj myslím si, bude umístěn osově přesně na druhou stranu. Tj. takhle. (Tohle pak musím ještě znovu zkontrolovat - v kódu by na to bylo dobré udělat přepínátko.)

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

Zatím jsem do antény doplnil pouze vrstvu "QFHBAL01-User_Comments.dxf" na které jsou vidět kóty a obrysy.

Další potíš je domnívám se ta, že aktuálně pozice RF konektoru vychází přesně do křížení mřížky.
Tady jsem vytvořil nový obrázek, který má doplněny kóty ke konetoru.

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

Konektor potřebuje ze spodní strany kruh volného prostoru o průměru minimálně 8mm, aby do něj bylo možné připojit nebo odpojit koaxiální kabel.

kaklik, 2020-11-25:
Tak správná orientace QFHBAL na spodní straně antény je tahle:

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

Čevené značky SCAD souboru jsou sesouhlaseny s orintací PCB na levém obrázku.

Parametry rozměrů, které jsou nyní [přímo v kódu antény](https://github.com/ODZ-UJF-AV-CR/QFH-Antenna/blob/e0976c53d5830cff4555565b1e6811471ef7c436/QFH-Antenna.scad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) by měly být přesunuty do [souboru s parametry](https://github.com/ODZ-UJF-AV-CR/QFH-Antenna/blob/master/parameters.scad).

kaklik, 2020-12-06:
Antény byly přilepeny 3M dual-lock suchým zipem na víko gondoly.

Closed 2020-12-06.

Thread 42 (2019-12-02):

V gondole používat různé napájecí zdroje

kaklik, 2019-12-02:
Při letu Fík5 se příliš neosvědčilo použití [primárních lithiových článků](https://www.tme.eu/cz/details/saft-ls33600/baterie/saft/ls-33600/). Díky jejich nízké proudové zatížitelnosti, která během krátkého letu tlakového stratosférického balonu v podstatě neumožňuje využít plnou kapacitu článku.   Důsledkem tak je, že část hmotnosti článků je v podstatě nevyužitelný balast.

Lepším řešením by tak zřejmě bylo tyto primární lithiové články nechávat spíše pro referenční měření a záložní dohledávací systém, kde je předpoklad nízké spotřeby a potřeba dlouhé provozní výdrže.

Pro hlavní experiment by tak bylo vhodnější použití [LION2CELL01D modulu](https://mlab.cz/module/LION2CELL01D) vybaveného li-Ion akumulátory pro střední proudy.  Z tohoto modulu je pak potřeba vytvořit 5V napájení (autopilot a telemetrie) a 3.3V napájení pro experimentální elektroniku.
Pro případ, že dva články v serii nemají dostatečnou energetickou kapacitu pro spolehlivé napájení experimentu na ~6h provozu, tak by bylo potřeba mít řešení pro paralelní zapojení další dvojice lithiových článků k již existující dvojici na modulu.

Sommema4, 2020-10-23:
Znamená to teda, že se tím teda nebude napájet ten iontometr, jak jsem navrhoval na schůzce?

kaklik, 2020-10-23:
> Znamená to teda, že se tím teda nebude napájet ten iontometr, jak jsem navrhoval na schůzce?

Já tam teda vidím napsáno "Pro hlavní experiment by tak bylo vhodnější použití LION2CELL01D modulu vybaveného li-Ion akumulátory pro střední proudy. "  Tvůj, iontometr je hlavní experiment, ne? :)

kaklik, 2020-12-06:
V gondole se používá kombinace napájení z primárních článků AIRDOSu a nabíjecích akumulátorů v modulu LION2CELL, který má napájecí vstup vyveden mimo krabici gondoly a bude připojen k napájení až do okamžiku startu.

Closed 2020-12-06.

Thread 43 (2020-10-21):

Logické úrovně TX a RX na modemu

kaklik, 2020-10-21:
Telemetrický transceiver [ISM01A](https://github.com/mlab-modules/ISM01) má v současné době potíž s tím, že jeho logické vstupy potřebují 5V logické úrovně.
Autopilot ale v současném provedení poskytuje logické úrovně 3.3V.

V minulém letu byl tento problém vyřešen omezením komunikační rychlosti UARTu mezi autopilotem a modemem.

kaklik, 2021-09-16:
Tato záležitost byla konstrukční chybou ISM modemu, kde byly omylem naletovány RC členy na vstupy.

Closed 2021-09-16.
