ODZ-UJF-AV-CR/balon/HW/transceiver_M1_1_2016/Modem-Modem.pdf

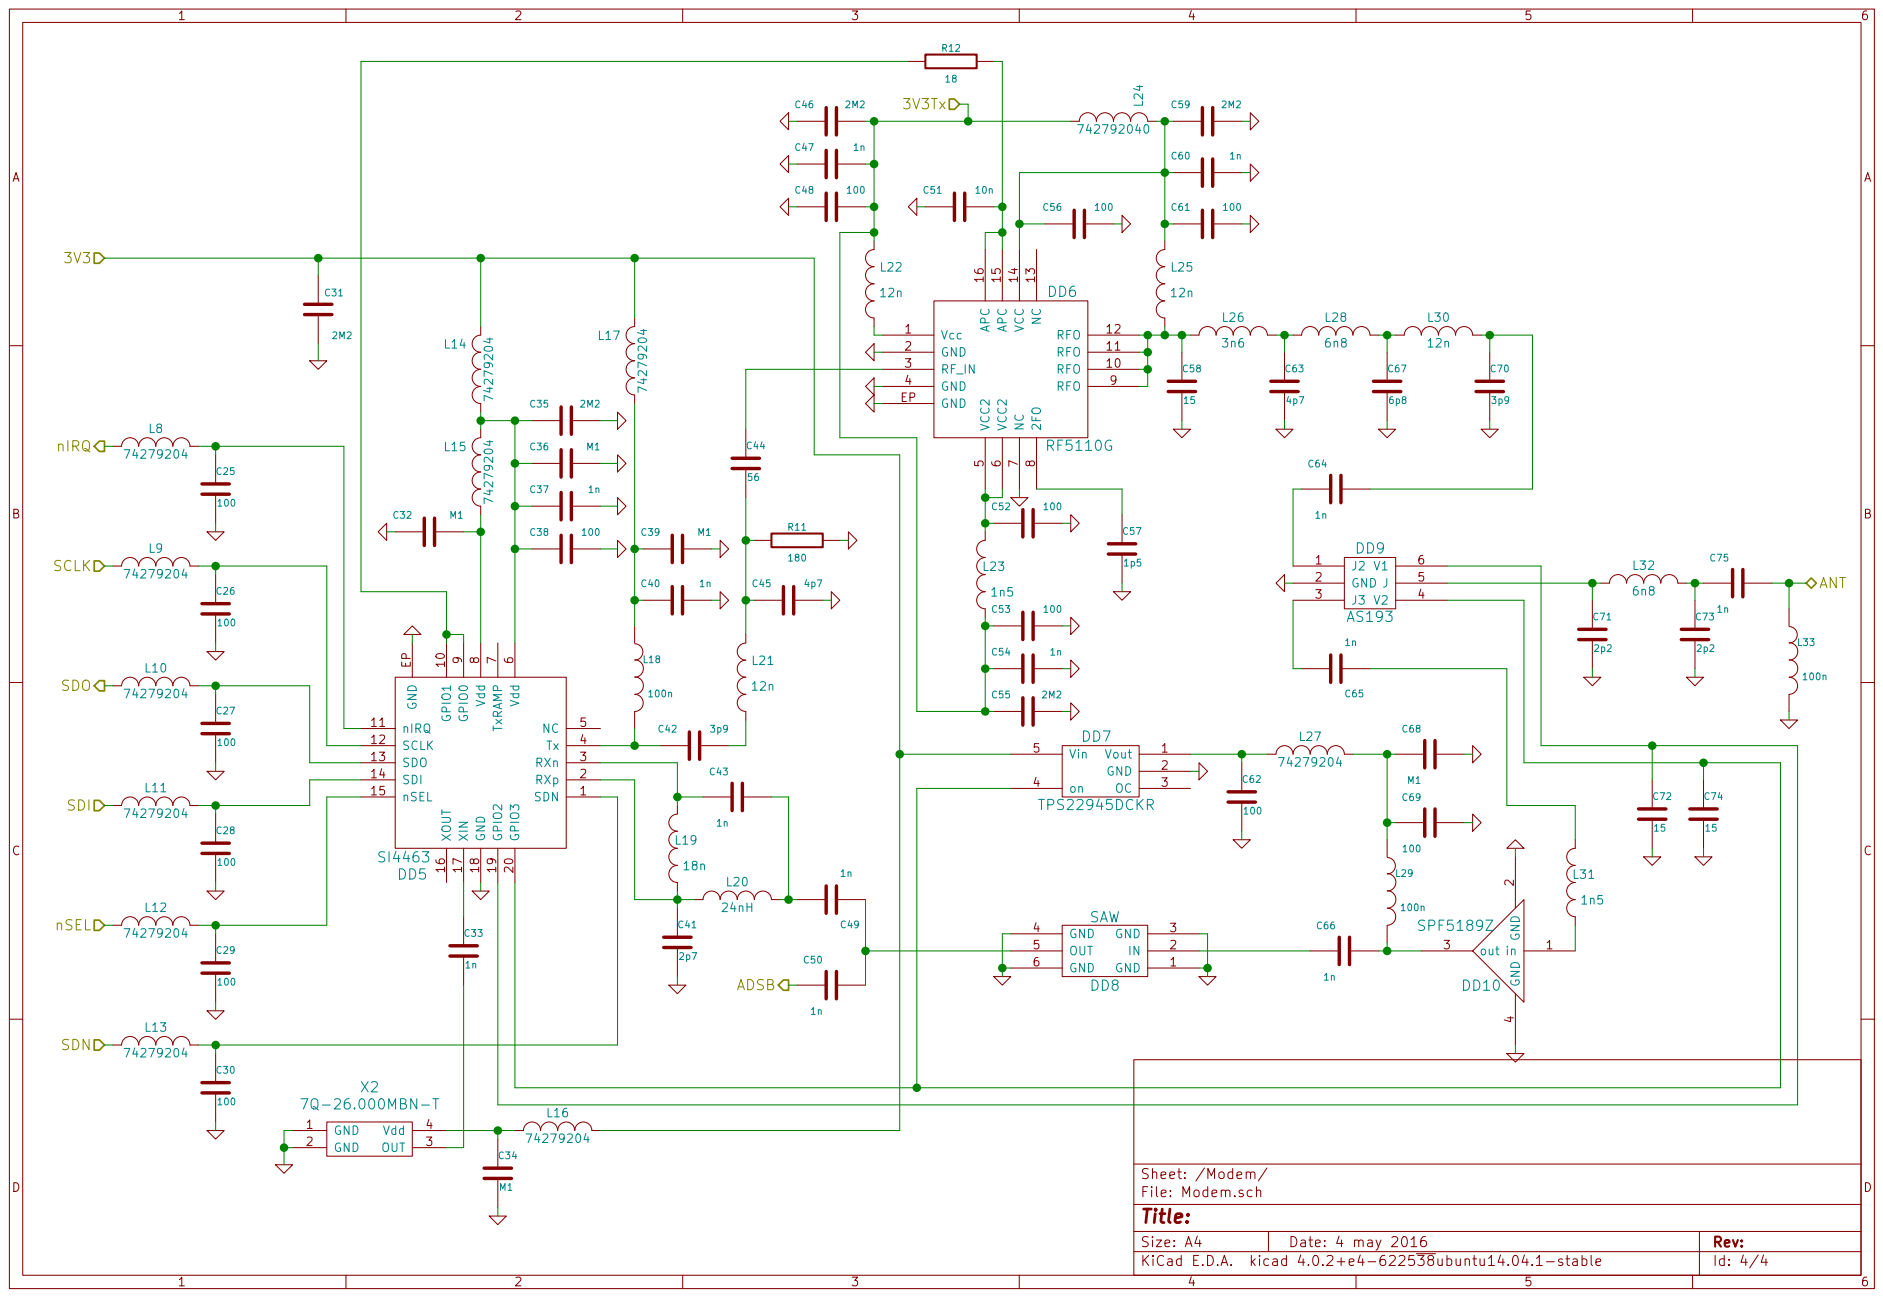
[picture p40: page 1]

8 RFO 9 RFO 10 RFO 11 RFO 12 NC 13 VCC 14 APC 15 APC 16 GND EP DD6 RF5110G

Id: 4/4 Title: File: Modem.sch Sheet: /Modem/
