ODZ-UJF-AV-CR/balon/presentation/sr-logika.pdf

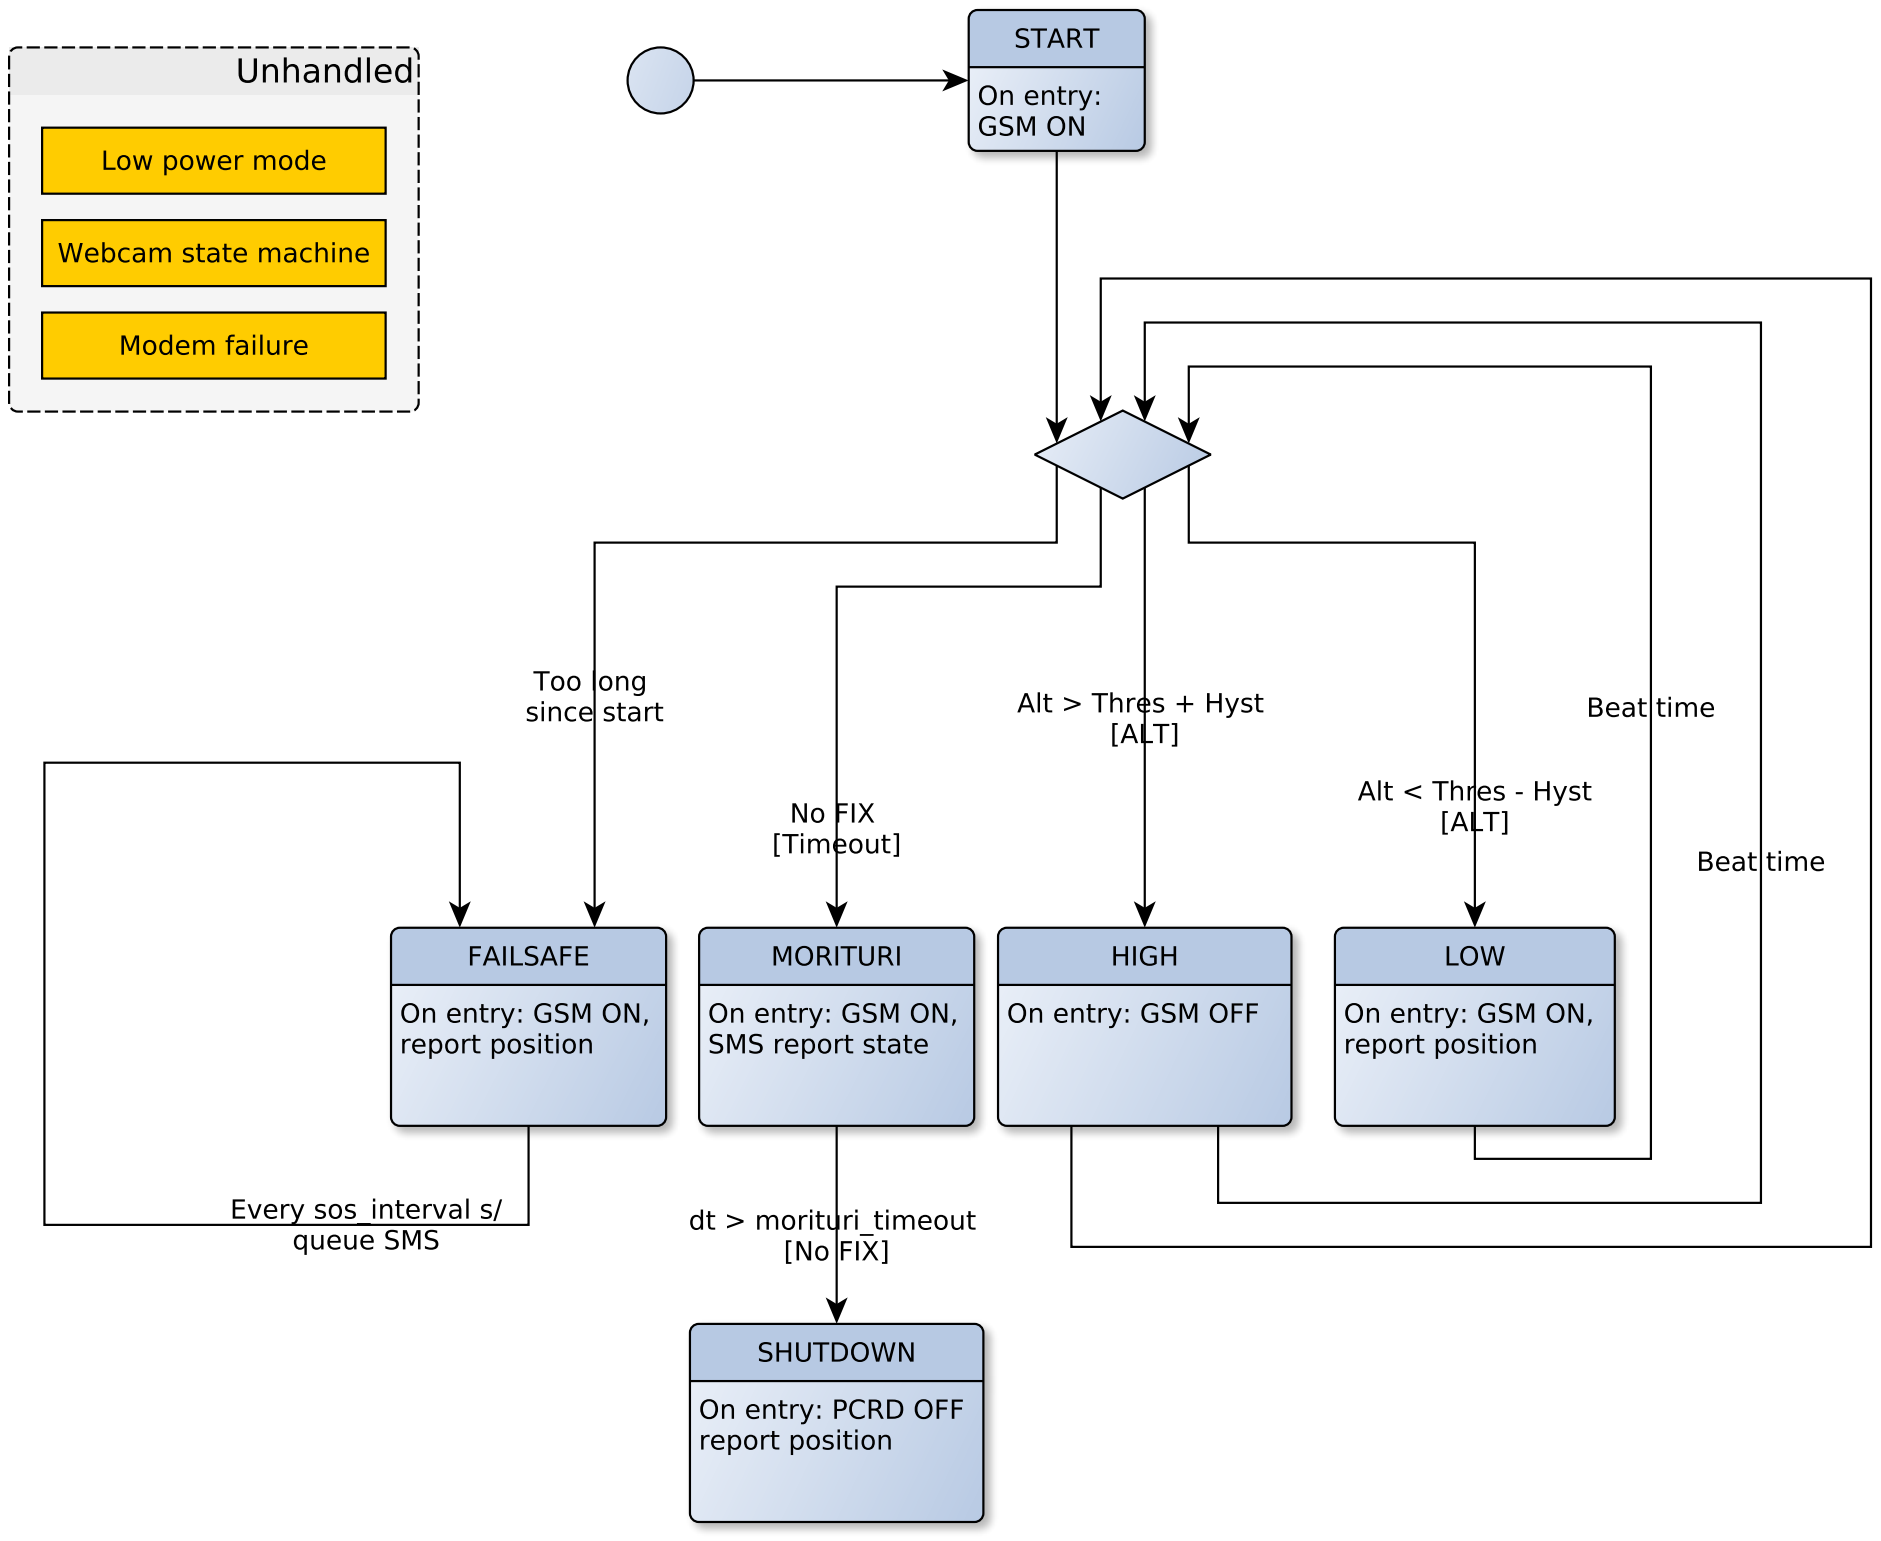
[picture p41: page 1]
