ODZ-UJF-AV-CR/balon/SW/spi/main.h

#include <16F877A.h>
#device adc=8

#FUSES NOWDT                 	//No Watch Dog Timer
#FUSES HS                    	//High speed Osc (> 4mhz for PCM/PCH) (>10mhz for PCD)
#FUSES PUT                   	//Power Up Timer
#FUSES NOPROTECT             	//Code not protected from reading
#FUSES NODEBUG               	//No Debug mode for ICD
#FUSES NOBROWNOUT            	//No brownout reset
#FUSES NOLVP                 	//No low voltage prgming, B3(PIC16) or B5(PIC18) used for I/O
#FUSES NOCPD                 	//No EE protection
#FUSES NOWRT                 	//Program memory not write protected

#use delay(clock=20000000)
