ODZ-UJF-AV-CR/balon/scripts/m_settings.py

#!/usr/bin/python
# Global settings

data_dir = '/data/balon/'
image_dir = data_dir + 'img/'

round_beat = 5

alt_radio_off = 8000
alt_radio_on = 7000

sms_delay_min = 15
sms_delay_max = 3*60

alt_diff_sms_trigger = 500

sms_phone_number = "00420775268014"

data = {}
