ODZ-UJF-AV-CR/balon/(commit log)

2015-11-25 balon.py->monitor.py - watches GPS, CPU and sensors
2015-11-25 Send current position using shell script
2015-11-27 Threaded cam.py - to be integrated in monitor.py
2015-11-29 Better GSM module initialization error handling
    [monitor.py]
2015-11-29 Corrected format error in data file output
    [monitor.py]
2015-11-29 Sensor data stored in dictionary. Typo fixes.
    [monitor.py]
2015-11-29 some SPI test
2015-12-01 GPSdataloger SW, ATmega328P, Arduino
2015-12-02 Corrected timeout issue in gpstime.py
    [gpstime.py]
2015-12-02 Let gps time continue even without 3D fix.
    [gpstime.py]
2015-12-02 cam.sh adjusted to the new cameras
2015-12-02 Do not require fix for time retrieval at all
    [gpstime.py]
2015-12-03 Add an exception for failed battery sensor
    [monitor.py]
2015-12-04 time print
2015-12-07 New 3D printable base for balloon elecronics.
    [PLBASE1515.scad, PLBASE1515.stl]
2015-12-08 README.md for spi dir
2015-12-08 Freezer experiment logs added
    [data_log.csv]
2015-12-08 Battery data writeout fix. Multiple webcams supported now.
    [monitor.py]
2015-12-08 Added error handling for wrongly named video devices
    [monitor.py]
2015-12-09 Threaded version of PCRD poller
2015-12-09 PCRD reader script in threaded version
2015-12-09 monitor.py better i2c fails handling
    [monitor.py]
2015-12-15 i2c module test version
2015-12-16 Added printout of weighted sum in m_pcrd.
2015-12-16 standalone exec of m_webcam disables/enables camera periodically
2015-12-16 i2c data dict accessible via i2c object now
2015-12-16 Added voltage threshold for low power mode
2015-12-16 Added low power mode based on voltage thresholds.
2015-12-16 Climb/Track/errors logged from GPS now
    [m_gps.py, monitor.py]
2015-12-16 Added Climb/Bearing/Speed to SMS and adjusted logging
2015-12-17 i2c now computes and reports barometeric altitude and climb rate
2015-12-18 removed brownout reset and introduced watchdog
    [main.c, main.h]
2015-12-18 BROWNOUT reset was introduced
    [main.h]
2015-12-21 Block schematics of piNav-L1 GPS data logger subsystem.
2015-12-21 Block schematics of radio beacon added.
2015-12-21 151219_flight data
    [boots.csv, data_corrected.csv, data_final.csv, data_log.csv, kovarova_gps.csv]
2016-03-16 link to block schematics repaired.
2016-05-09 new transceiver design.
    [Modem.sch, _saved_modballoon.sch, mcu.sch, modballoon.sch, pwr.sch, pwr2.sch]
2016-05-16 PCB of transceiver designed.
    [Modem.sch, mcu.sch, modballoon.csv, modballoon.kicad_pcb, modballoon.sch, pwr.sch]
2016-05-18 Create wiring
2016-07-07 Added schematics files
    [_saved_modballoon.sch, mcu.sch, modballoon.kicad_pcb]
2016-09-06 new protection feature - inverted power supply protection diode.
    [Modem.sch, mcu.sch, modballoon.kicad_pcb, modballoon.sch, pwr.sch]
2016-09-16 PCB modifications
    Modification of dimensions PCB
    [modballoon.kicad_pcb]
2016-09-21 Modifications insulating gap
    [modballoon.kicad_pcb]
2016-09-21 PCB generate production data
    [modballoon-B.Cu.gbr, modballoon-B.Mask.gbr, modballoon-Edge.Cuts.gbr, modballoon-F.Cu.gbr, modballoon-F.Mask.gbr, modballoon-F.SilkS.gbr, modballoon-In1.Cu.gbr, modballoon-In2.Cu.gbr]
2016-10-14 NEW .CSV
    [modballoon.csv]
2016-11-27 New version
    [Modem.sch, mcu.sch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]
2017-02-25 Modem is now attached to the USB-to-4xUART
2017-02-26 Commit of initial helix antenna design source code.
    [Telemetry_helix_868.scad]
2017-02-26 New telemetry antenna for radio modem.
    [Telemetry_helix_868.scad]
2017-02-27 FIX: Diameter of antenna loop was handled as radius.
    [Telemetry_helix_868.scad]
2017-03-08 New housing for PCRD detector.
    [Box_grid.stl, Telemetry_helix_868.scad, box_base.scad, box_base.stl, box_grid.scad, box_top.scad, box_top.stl]
2017-03-08 New helix base modelled.
    [Telemetry_helix_868.scad]
2017-03-09 New box design for telemetry receiver.
    [BASEBOX02A.scad, BASEBOX02A.stl, BASEBOX02A_PLBASE_top.scad, BASEBOX02A_PLBASE_top.stl, BASEBOX02A_kryt.scad, Letters.dxf, MLAB_logo.scad, Write.scad]
2017-03-09 MLAB logo added to box side.
    [BASEBOX02A.stl, bocnice.scad]
2017-03-09 antenna base changed to the grid.
    [Telemetry_helix_868.scad]
2017-03-09 Lightening of Antenna base.
    [Telemetry_helix_868.scad]
2017-03-13 Add filter for not GPGGA data inputs
2017-03-13 height of receiver box increased to fit SMA extension cable. A new hole for packet receive indication LED created in to side wall.
    [BASEBOX02A.stl, configuration.scad, upravena_bocnice.scad]
2017-03-13 improved filter for unwanted GPS data
2017-03-15 Bottom cover for receiver box generated.
    [BASEBOX02A_kryt.stl]
2017-03-15 Box with two types of exiting tunels for wires.
    [Pokus6.scad, Pokus7.scad]
2017-03-17 on-board software state as of mid-friday
2017-03-17 on-board software as of late friday
2017-03-17 last fixes to on-board sw
    [launcher.py, monitor_p.py]
2017-03-20 CANDY with GPS with power sawing
2017-03-29 first antenna prototype simulation.
    [Telemetry_helix_868.scad]
2017-03-29 slightly modified antenna geometry model.
2017-03-29 Data from March 2017 flight
    [CONFIG.TXT, data_koule.csv, data_log.csv]
2017-04-02 more effective GPS Fix time
    [candy_letadlo.ino]
2017-04-03 moved and filtered tracker log data
    [LetFik2_HabHub_data.csv]
2018-01-14 Cleanup of prited parts directory.
    [BASEBOX02A.scad, BASEBOX02A.stl, BASEBOX02A_PLBASE_top.scad, BASEBOX02A_PLBASE_top.stl, BASEBOX02A_kryt.scad, BASEBOX02A_kryt.stl, Base_long.stl, Box_grid.stl]
2018-01-14 Really used models were moved to subdirectories.
    [BASEBOX02A.scad, BASEBOX02A.stl, BASEBOX02A_PLBASE_top.scad, BASEBOX02A_PLBASE_top.stl, BASEBOX02A_kryt.scad, BASEBOX02A_kryt.stl, Deska+C1.scad, Deska+C1_14.stl]
2018-01-19 New printed base for dosimeter.
    [Base-Fik3.scad, Base-Fik3.stl]
2018-01-19 Rendering new STL.
    [Base-Fik3.stl]
2018-01-20 New version of box for multiphotodiode detector.
    [Box-Fik3.scad, Box-Fik3.stl, BoxBase-Fik3.scad, BoxBase-Fik3.stl]
2018-01-22 Vzorkovnik pro odhad spravneho prumeru otvoru na sroub M3.
    [VzorkovnikSloupkuNaSroubM3.scad, VzorkovnikSloupkuNaSroubM3.stl]
2018-01-23 Column sampler enhanced by supporting base.
    [VzorkovnikSloupkuNaSroubM3.scad, VzorkovnikSloupkuNaSroubM3.stl]
2018-02-08 Payload telemetry log from habhub added.
    [payload_habhub.csv]
2019-11-03 Add script to read telemetry test logs
    In the test, a beacon was transmitting timestamp messages while
    switching modulation settings in an absolute-time-dependent manner.
    A receiver followed the modulation changes and saved the received
    messages.
    These scripts convert timestamps to the modulation settings applied at
    the time.
2019-11-20 Návrh držáku pro anténu na střechu auta.
    [antenna_holder.scad, antenna_holder.stl, parameters.scad]
2019-11-21 Přidání drážky pro vývod kabelu. Vylepšení tolerancí.
    [antenna_holder.scad, antenna_holder.stl, parameters.scad]
2019-11-25 camera parameters
    [camera_holder.scad, parameters.scad]
2019-11-26 camera holder
    [camera_holder.scad, camera_holder.stl, parameters.scad]
2019-11-30 Replaced with design from https://github.com/kaklik/QFH-Antenna Repository.
    [Telemetry_helix_868.scad]
2020-01-01 Adding antenna reflection coeficient measurement.
2020-01-16 Added a gcode and screenshot of antenna holder.
2020-05-04 Telemetry modem block schematics.
